MR-DOS/PWRLOAD-G1/README.md

# PWRLOAD-G1
DC constant current / constant power digitally controlled load, bachelor thesis in 2017
