MR-DOS/PWRLOAD-G1/exam/obhajoba_BP_final.pdf

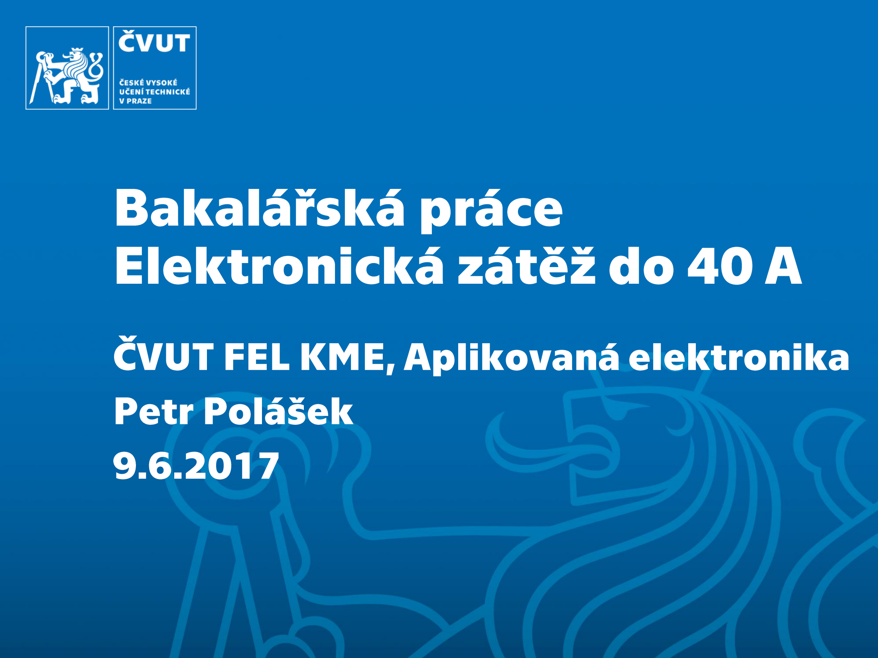
[picture p1: page 1]

1) Cíl práce
2) Základní myšlenky konstrukce
3) Princip funkce zátěže
4) Zapojení zpětnovazební smyčky
5) Digitální řízení
6) Mechanická konstrukce
7) Změřené parametry
8) Ukázka ovládání

Prostudovat problematiku zatěžování zdrojů Navrhnout a realizovat elektronickou zátěž schopnou zatěžovat zdroj s maximálním proudem do 40 A pro napětí do 100 V

Modularita
Softwarové řízení
Galvanické | oddělení výkonových | částí
obvodů od uživatelské části
Důraz na minimalizaci ceny zařízení

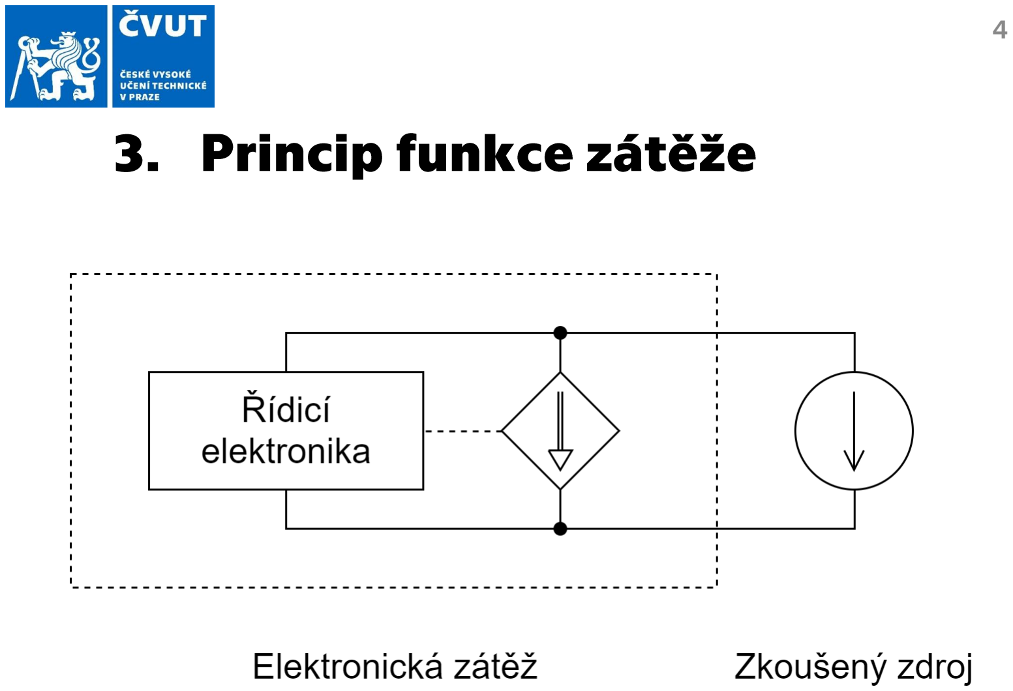
[picture p2: page 5]

Realizován přímo koncepcí zařízení jako proudové nory

Realizován simulací konstantního příkonu pomocí měření napětí na zatěžovaném zdroji a řízení proudu zátěží

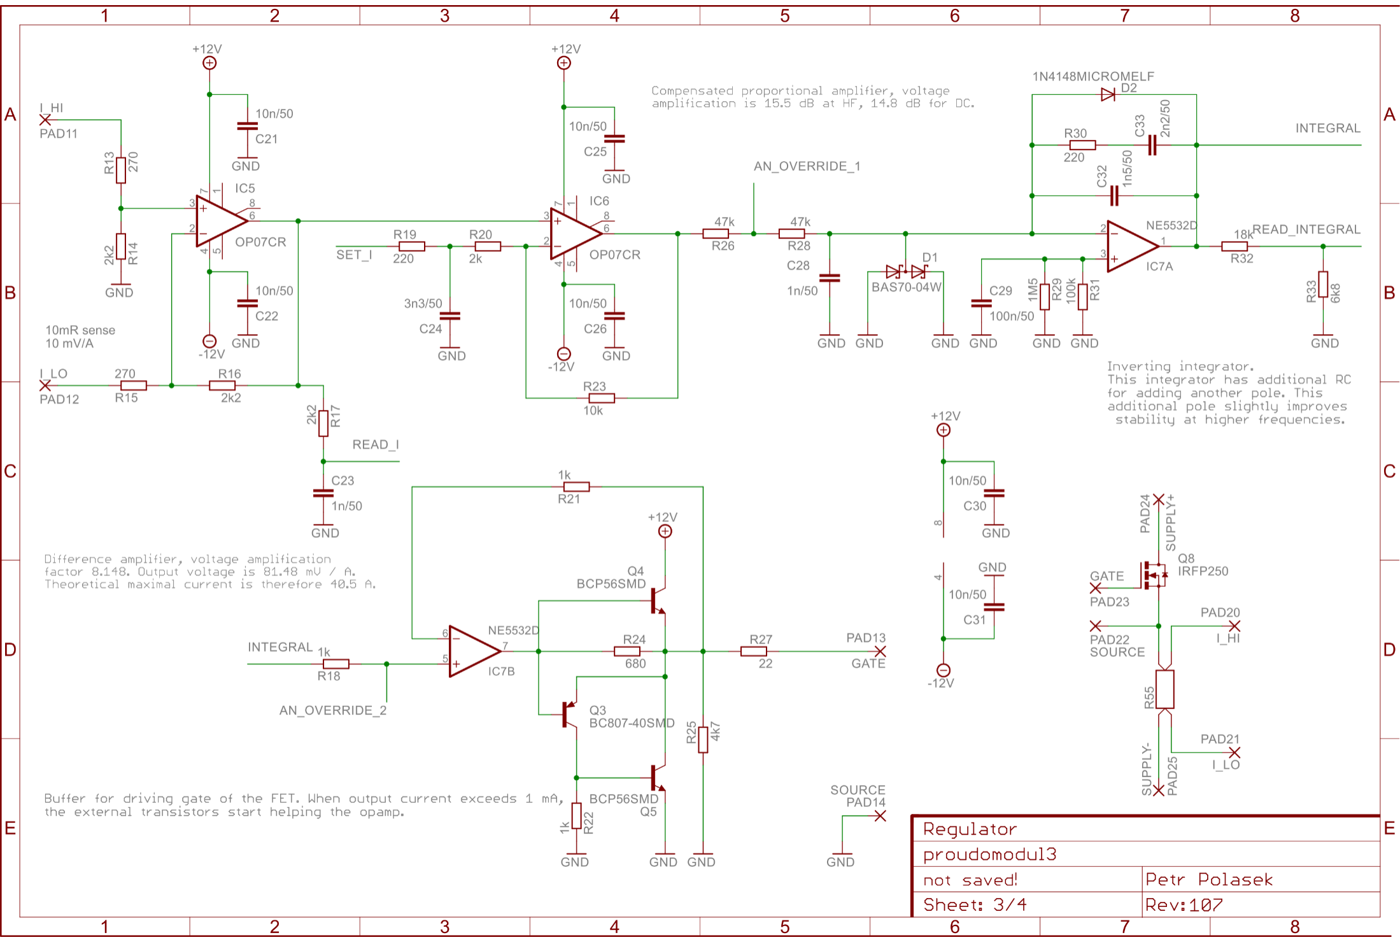
[picture p3: page 8]
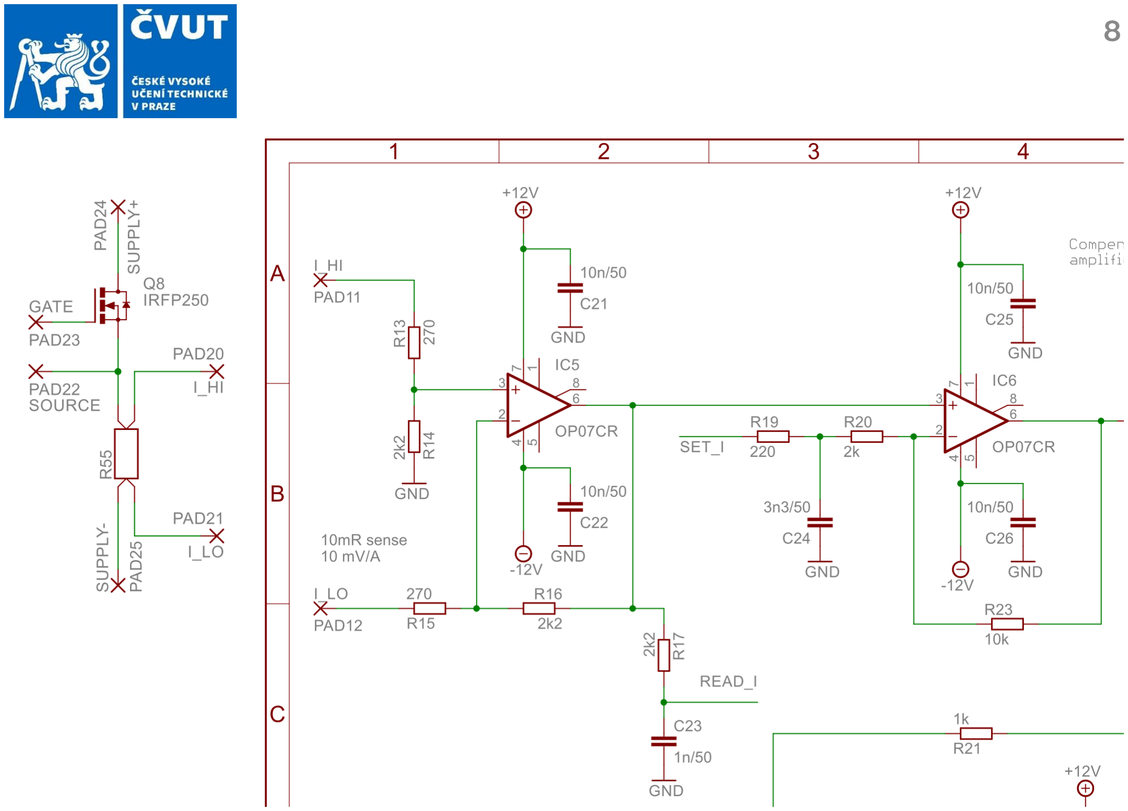
[picture p4: page 9]

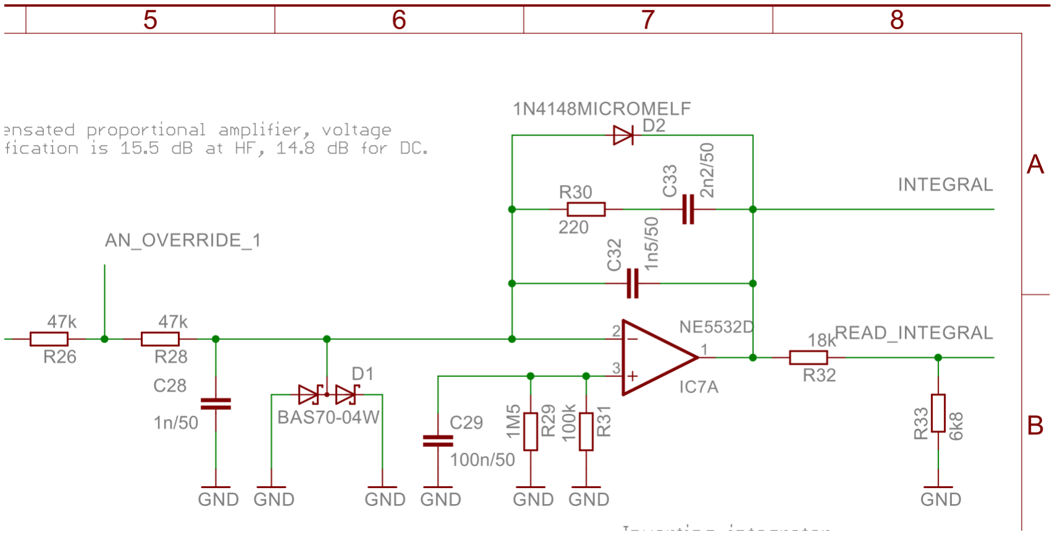
[picture p5: figure]

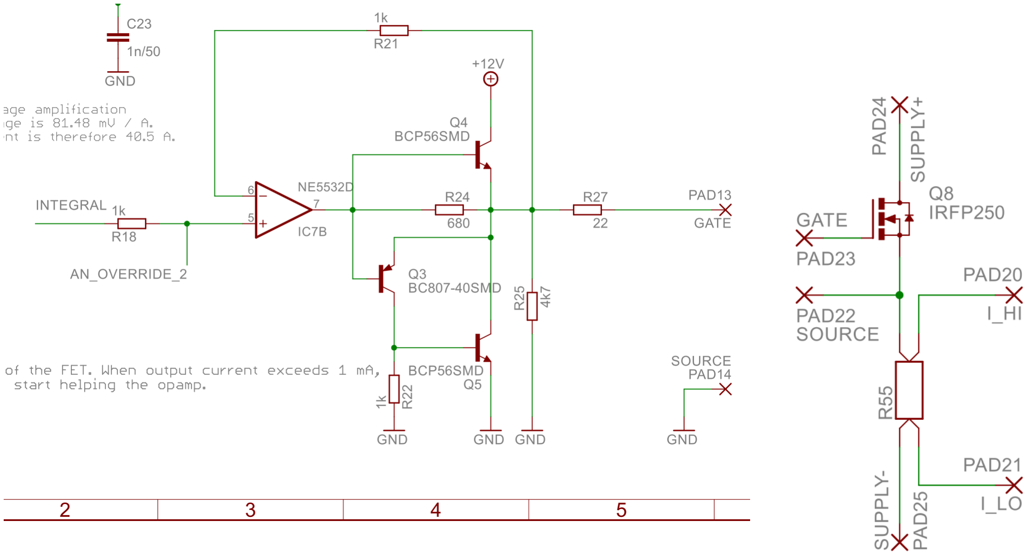
[picture p6: figure]
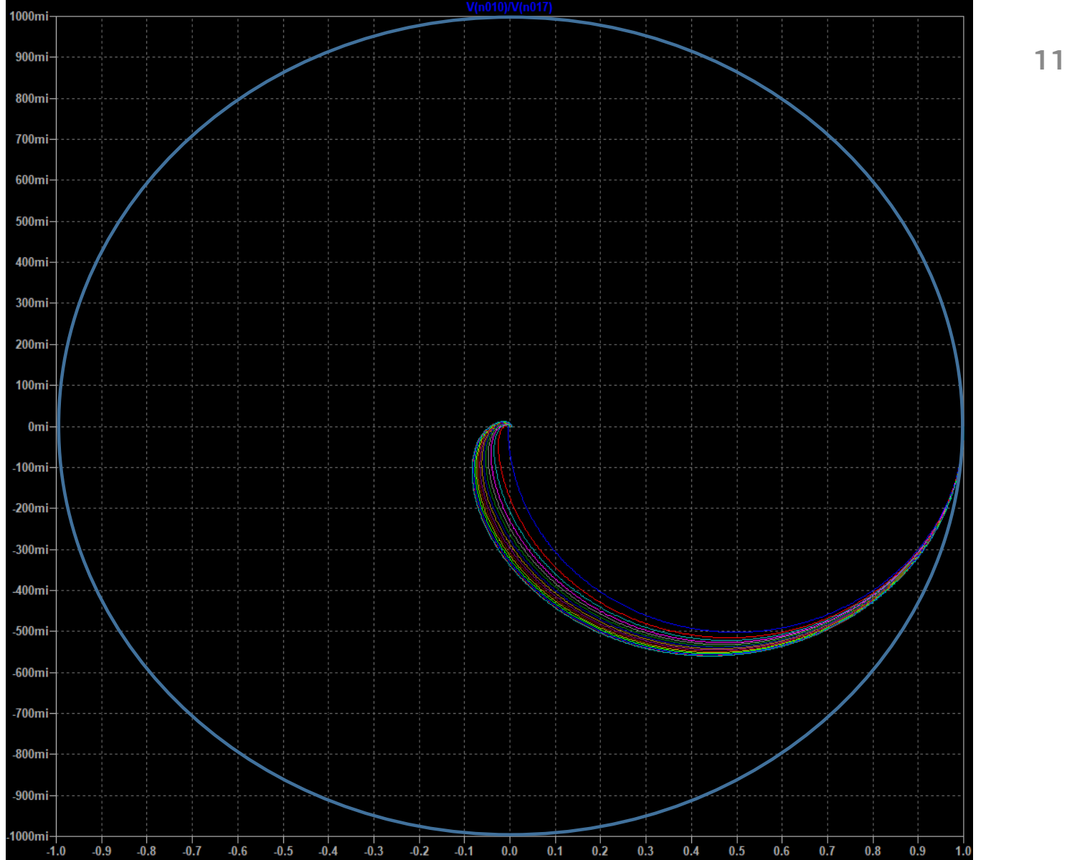
[picture p7: page 12]

Hlídání chybových stavů

Proudové přetížení

Výkonové přetížení
Přehřátí

Napětí zdroje
Řízení zátěže

Simulace konstantního příkonu

Digitální komunikace
Redukce počtu analogových obvodů

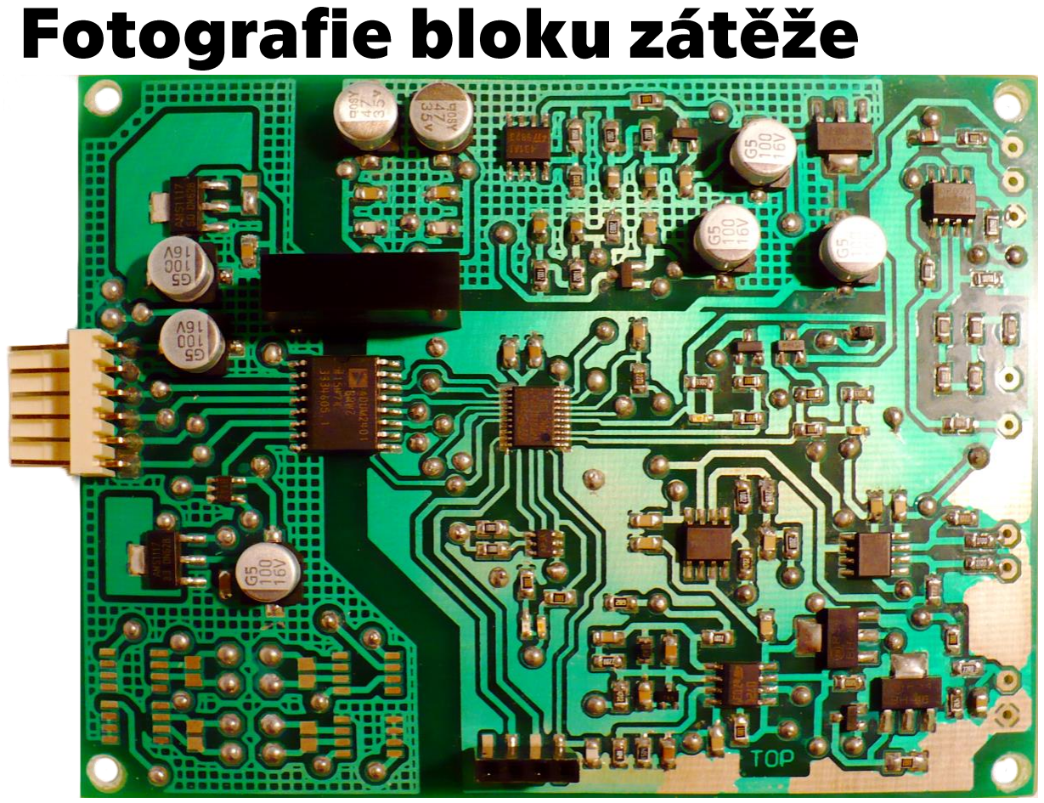
[picture p8: figure]
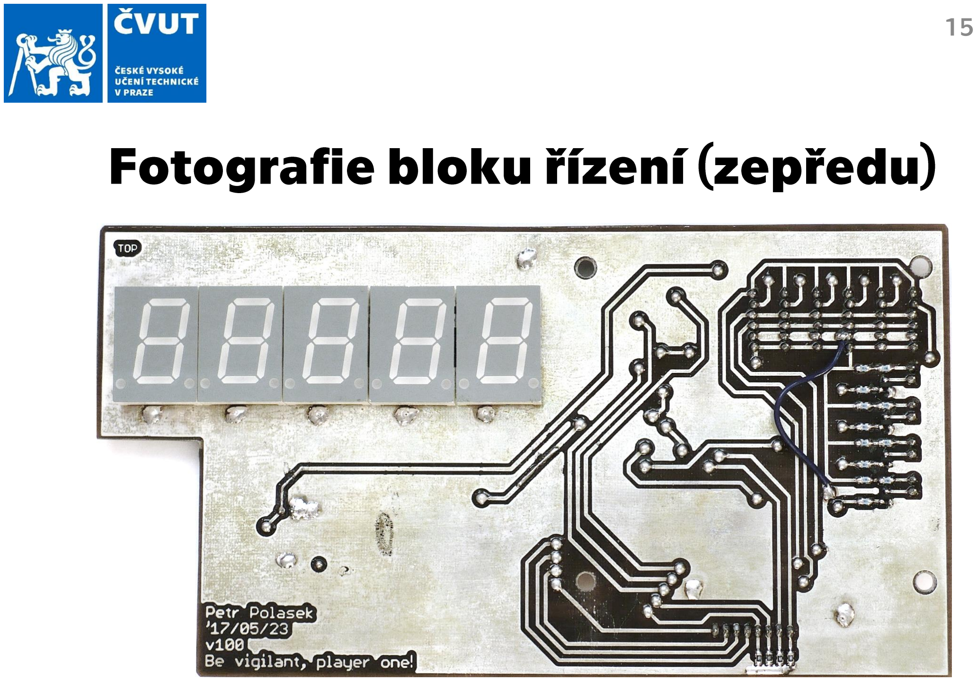
[picture p9: page 16]
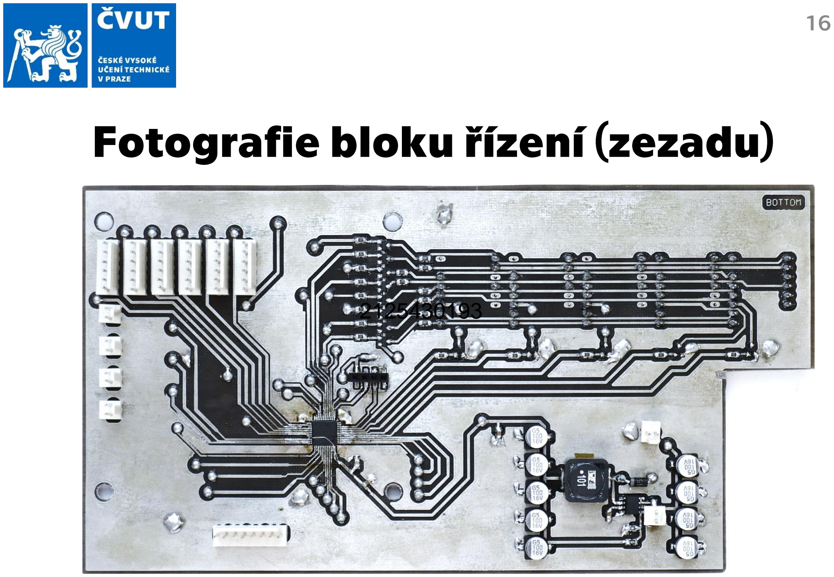
[picture p10: page 17]

2125430193

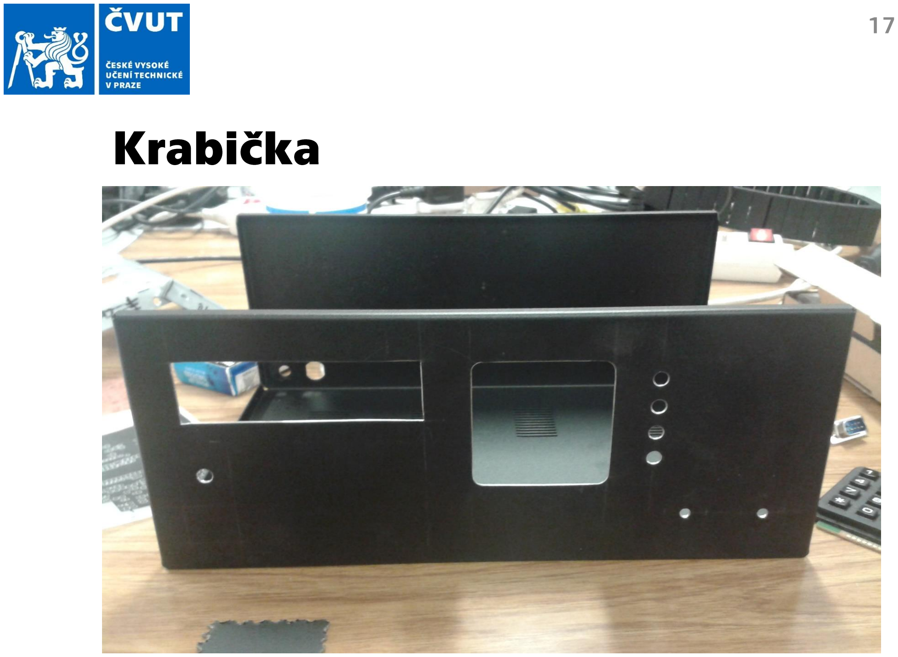
[picture p11: page 18]

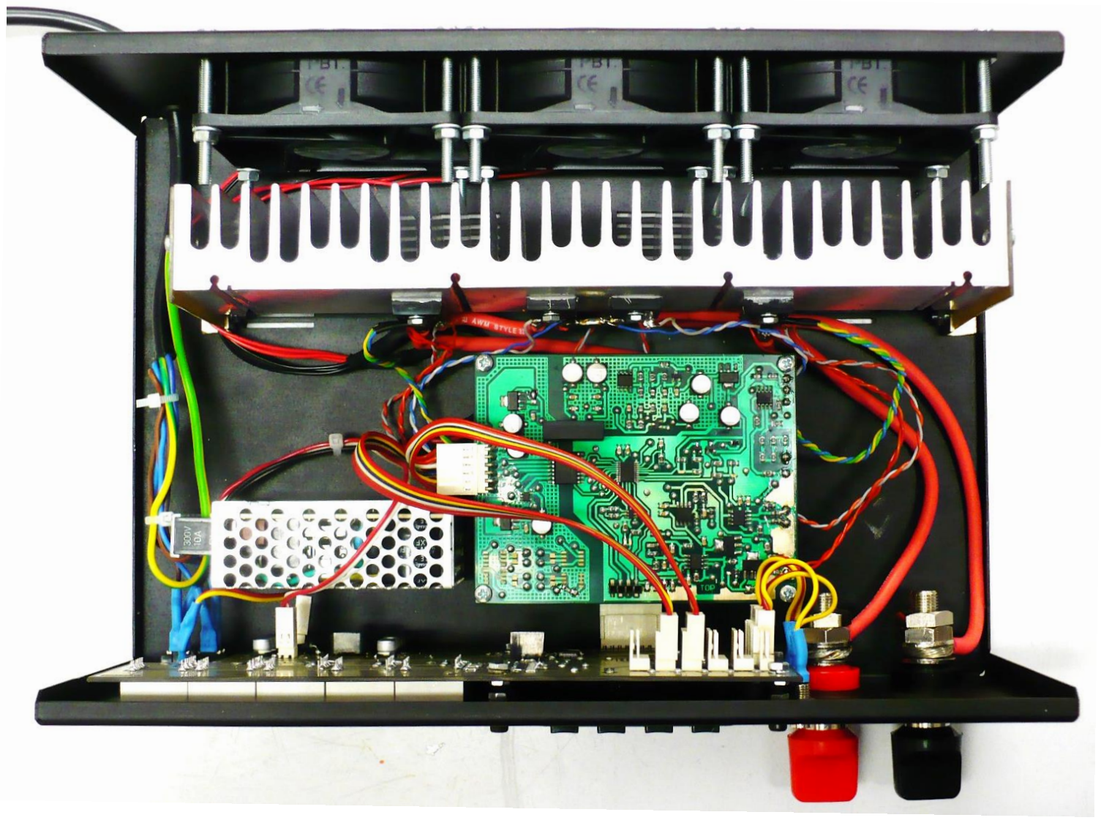
[picture p12: figure]

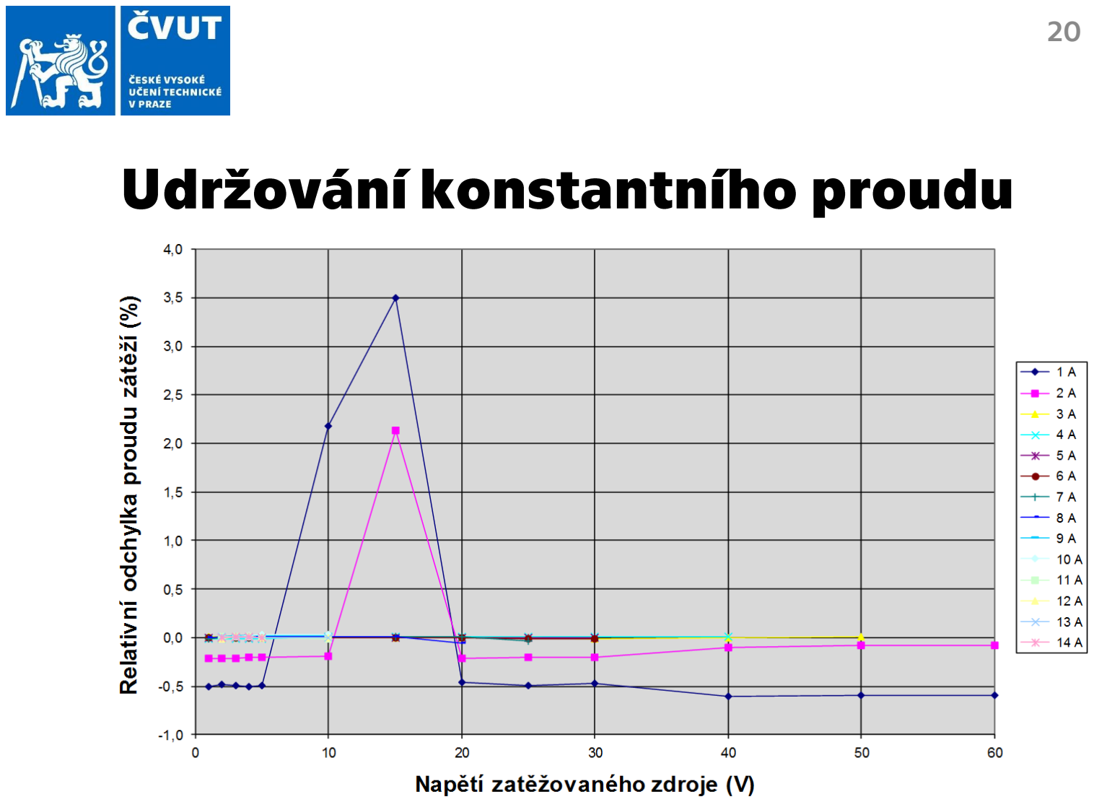
[picture p13: page 21]
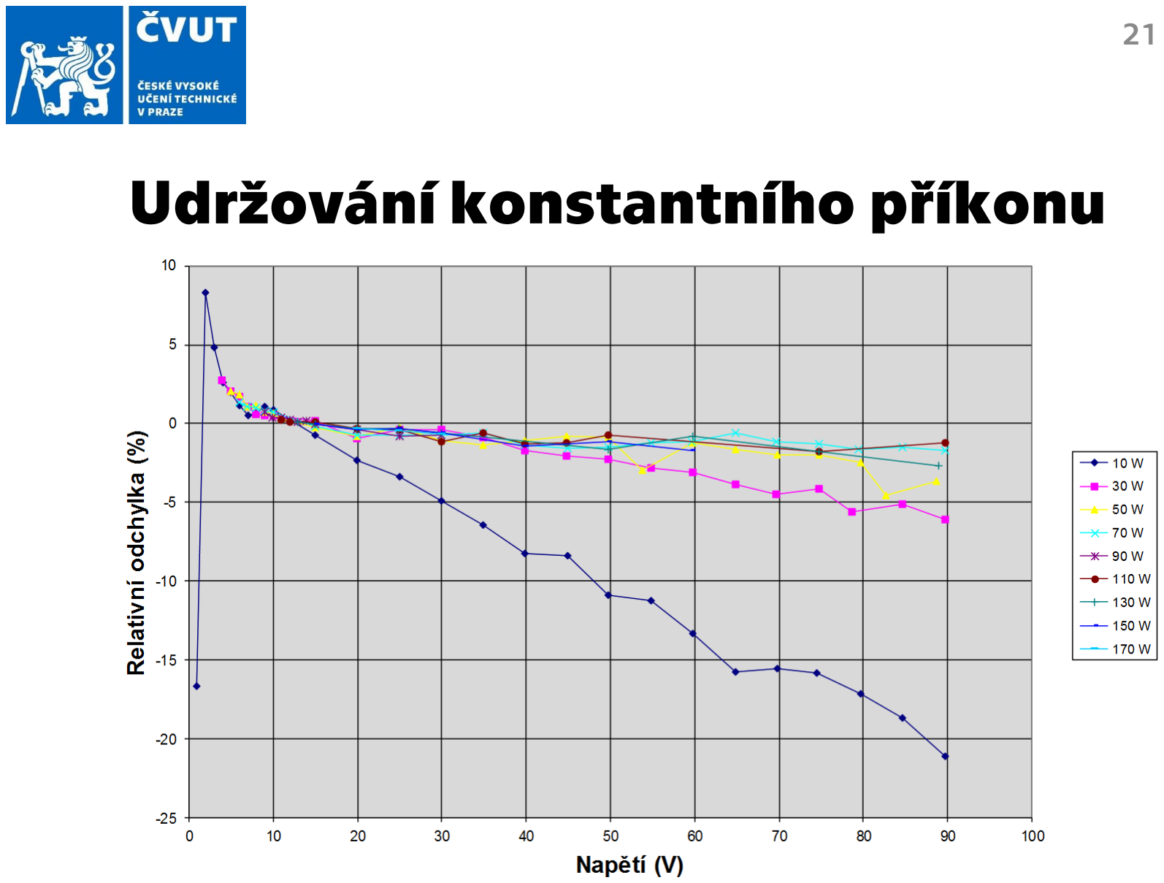
[picture p14: page 22]
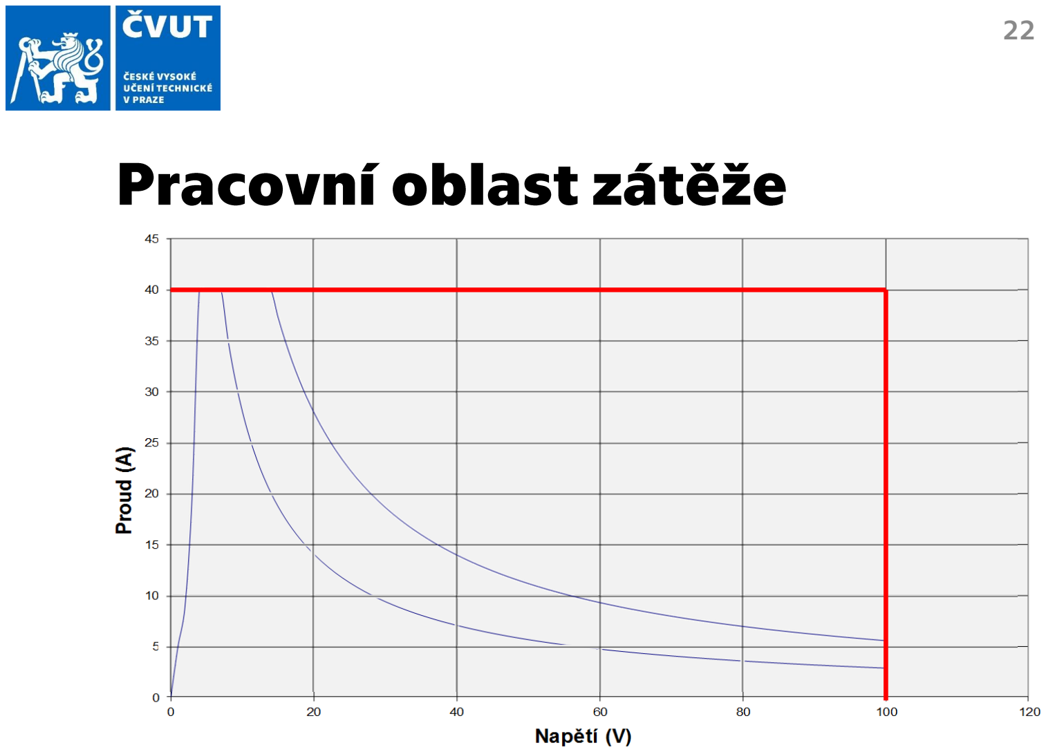
[picture p15: page 23]

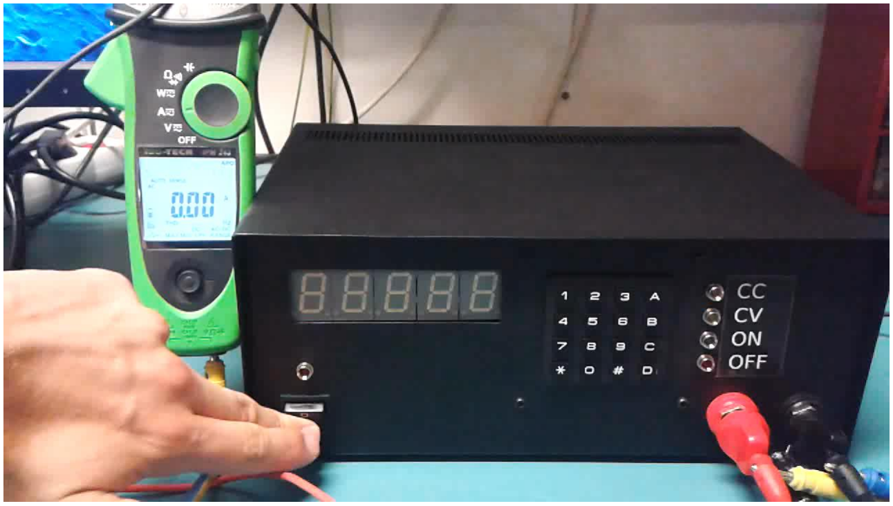
[picture p16: figure]

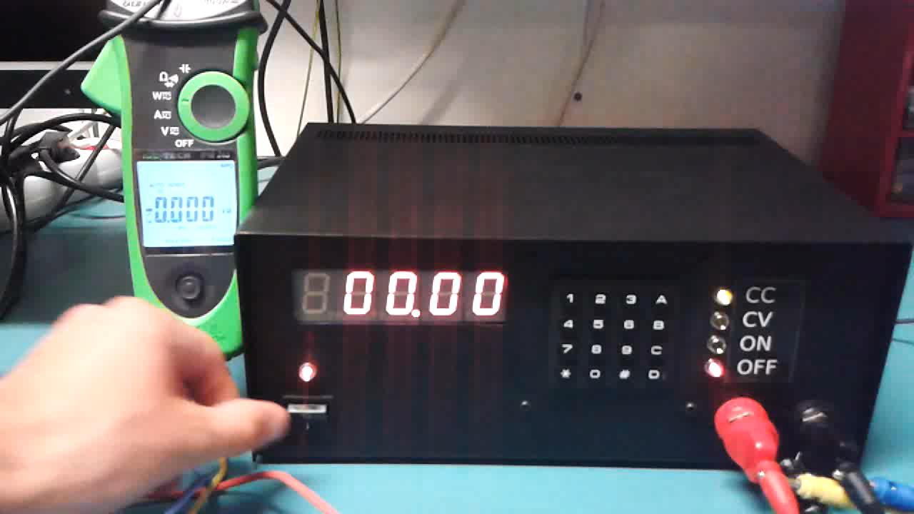
[picture p17: figure]

Prostudovat problematiku zatěžování zdrojů Navrhnout a realizovat elektronickou zátěž schopnou zatěžovat zdroj s maximálním proudem do 40 A pro napětí do 100 V

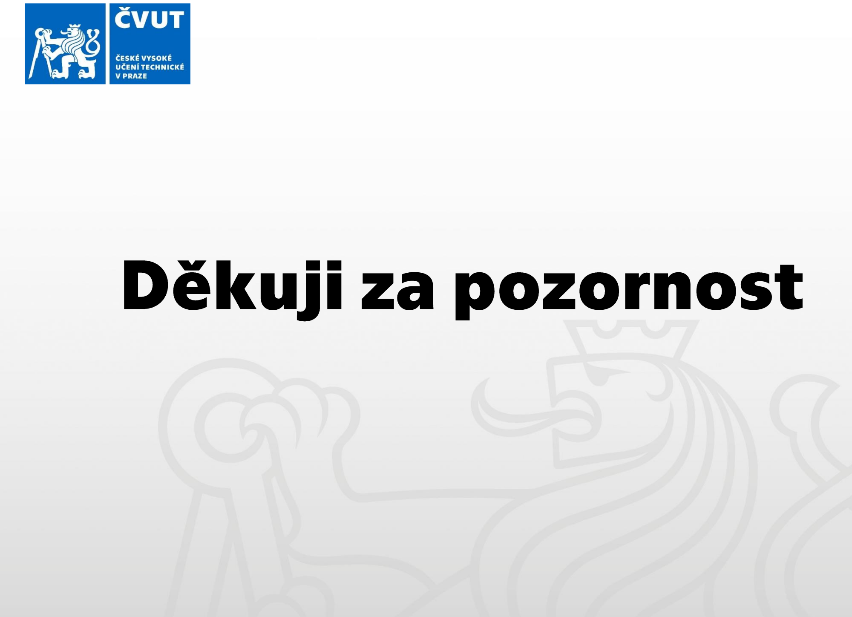
[picture p18: page 27]

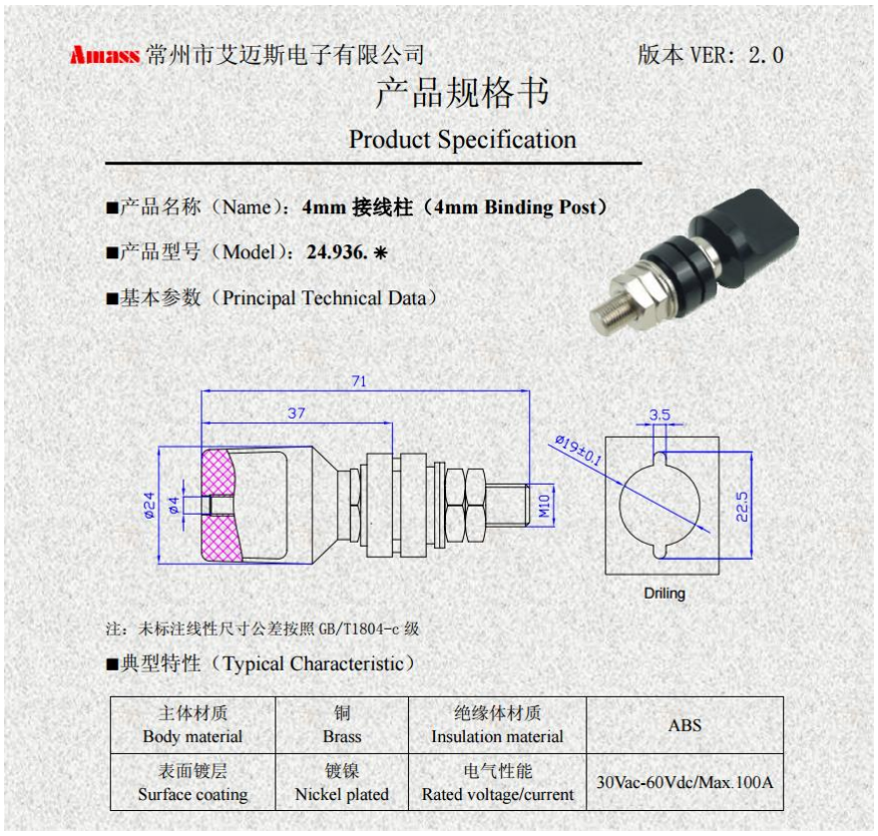
[picture p19: figure]
