MR-DOS/PWRLOAD-G1/thesis/namerena_data_prikon.xls

1 W |  |  |  | 10 W |  |  |  | 30 W
Napětí (V) | Proud (A) | Výkon (W) | Relativní chyba (%) | Napětí (V) | Proud (A) | Výkon (W) | Relativní chyba (%) | Napětí (V) | Proud (A) | Výkon (W) | Relativní chyba (%)
0.99 | 1.372 | 1.35828 | 35.828 | 0.938 | 8.890 | 8.339 | -16.612 | 3.942 | 7.820 | 30.826 | 2.755
1.995 | 0.5417 | 1.0806915 | 8.06915 | 1.960 | 5.527 | 10.833 | 8.329 | 4.950 | 6.186 | 30.621 | 2.069
2.994 | 0.338 | 1.011972 | 1.1972 | 2.973 | 3.526 | 10.483 | 4.828 | 5.960 | 5.120 | 30.515 | 1.717
3.99 | 0.2423 | 0.966777 | -3.3223 | 3.970 | 2.585 | 10.261 | 2.613 | 6.960 | 4.358 | 30.332 | 1.106
4.99 | 0.1883 | 0.939617 | -6.0383 | 4.980 | 2.048 | 10.200 | 1.995 | 7.960 | 3.791 | 30.176 | 0.588
5.99 | 0.1516 | 0.908084 | -9.1916 | 5.980 | 1.692 | 10.118 | 1.176 | 8.960 | 3.365 | 30.150 | 0.501
6.99 | 0.1258 | 0.879342 | -12.0658 | 6.980 | 1.440 | 10.049 | 0.491 | 9.960 | 3.028 | 30.159 | 0.530
7.99 | 0.1081 | 0.863719 | -13.6281 | 7.980 | 1.262 | 10.068 | 0.684 | 14.960 | 2.009 | 30.055 | 0.182
8.98 | 0.0928 | 0.833344 | -16.6656 | 8.980 | 1.126 | 10.108 | 1.079 | 19.960 | 1.489 | 29.720 | -0.932
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
