MR-DOS/PWRLOAD-G1/thesis/namerena_data_proud.xlsx

Měření závislosti proudu zátěží na napětí zdroje
Kodove slovo (-) | 119 | 243 | 368 | 491 | 615 | 738 | 862 | 987 | 1112 | 1236 | 1358 | 1481 | 1605 | 1730 |  | Hodnoty naměřené pomocí bočníku
Jmenovity proud (A) | 1 | 2 | 3 | 4 | 5 | 6 | 7 | 8 | 9 | 10 | 11 | 12 | 13 | 14
 |  |  |  |  |  |  |  |  |  |  |  |  |  |  |  | Proud (A)
Napeti (V) | Proud (A) |  |  |  |  |  |  |  |  |  |  |  |  |  | Napětí (V) | 6 | 7 | 8 | 9 | 10 | 11 | 12 | 13 | 14
1 | 1.0035 | 2.0056 | 3.0072 | 4.001 | 5.005 | 5.997 | 6.998 | 8.002 | 8.472 | 8.480 | 9.292 | 9.117 | 9.162 | 8.933 | 1 |  |  |  |  |  | 92.14 | 90.4 | 90.85 | 88.58
2 | 1.0033 | 2.0058 | 3.0072 | 4.001 | 5.005 | 5.997 | 6.997 | 8.001 | 9.002 | 10.000 | 11.004 | 11.998 | 13.001 | 14.009 | 2 |  |  |  |  |  | 109.11 | 118.97 | 128.91 | 138.91
3 | 1.0034 | 2.0056 | 3.0074 | 4.001 | 5.005 | 5.997 | 6.997 | 8.001 | 9.001 | 9.999 | 11.004 | 11.996 | 13.002 | 14.008 | 3 |  |  |  |  |  | 109.11 | 118.95 | 128.92 | 138.9
4 | 1.0035 | 2.0054 | 3.0072 | 4.001 | 5.005 | 5.997 | 6.997 | 8.001 | 9.001 | 9.998 | 11.004 | 11.996 | 13.002 | 14.008 | 4 |  |  |  |  |  | 109.11 | 118.95 | 128.92 | 138.9
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
