MR-DOS/PWRLOAD-G1/simulations/bap.asc

C1: cap; 3n3
C2: cap; 1n
C3: cap; 1n5
C4: cap; 2n2
M1: nmos; IRFP250N
Q1: npn3; BCW60A
Q2: npn3; BCW60A
Q3: pnp2; BC807-40
R1: res; 270
R2: res; 2k2
R3: res; 270
R4: res; 2k2
R5: res; 10k
R6: res; 2k
R7: res; 220
R8: res; 94k
R9: res; 220
R10: res; 1k
R11: res; 1k
R12: res; 10
R13: res; 1k
R14: res; 10m
U1: OP07
U2: OP07
U3: OP07
U4: OP07
V1: voltage; {DAC}; AC 0
V2: voltage; 10; AC 0
V3: voltage; 0; AC 1
V4: voltage; 11
V5: voltage; 11
Named nets: 0
.ac dec 10 1m 10k
;tran 0 30mm 0m 1u
.STEP param DAC 0.01 3.31 0.25
