MR-DOS/PWRLOAD-G1/HW_GUI/gui.brd

## EAGLE design HW_GUI/gui.brd (2022-01-06)

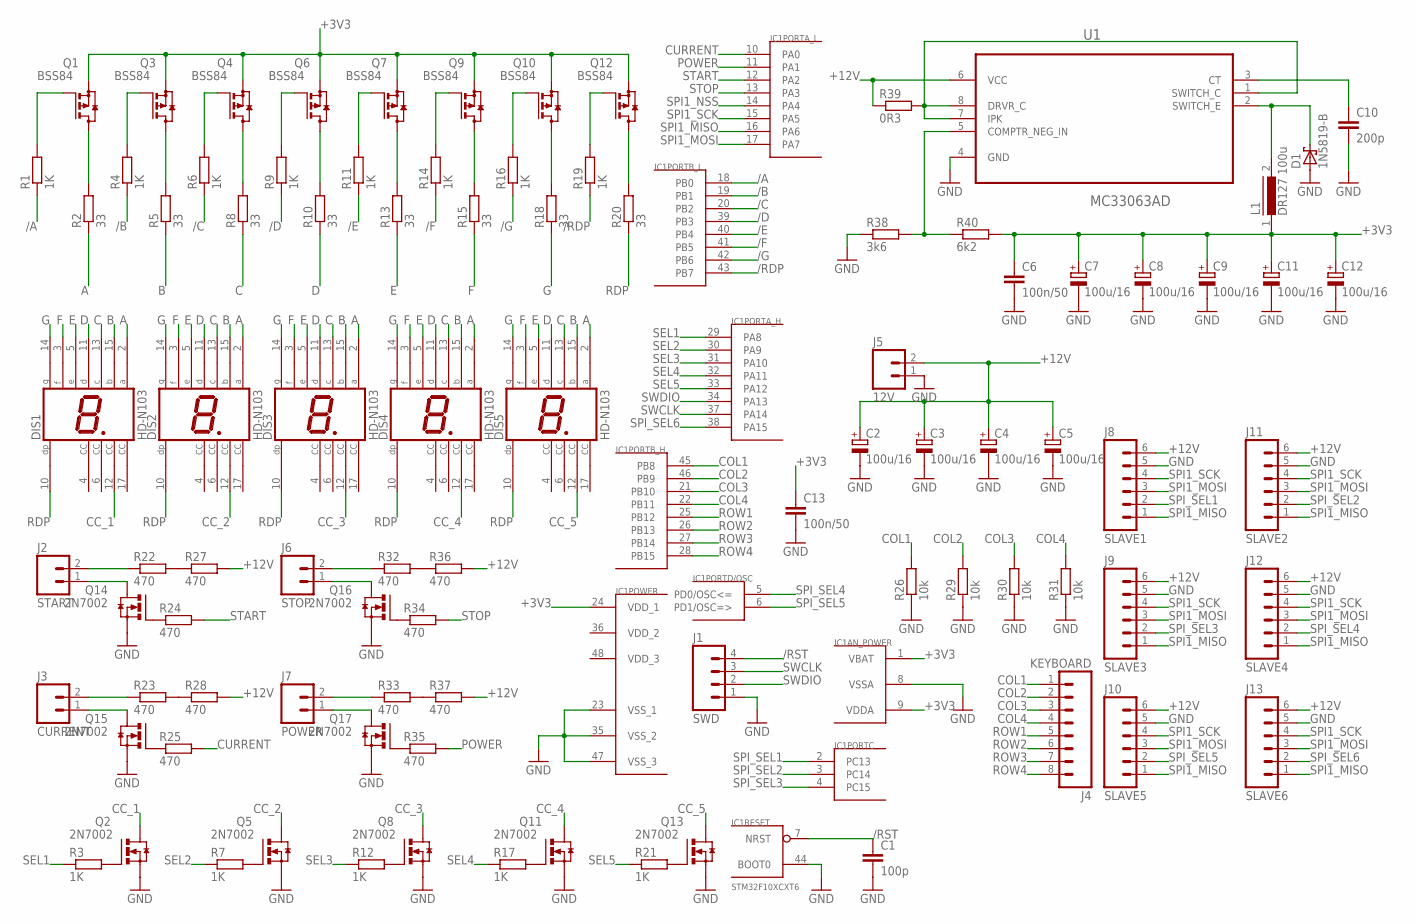
[picture p20: schematic gui.sch]

Parts:
C1: 100p; C0805
C2, C3, C4, C5, C7, C8, C9, C11, C12: 100u/16; 153CLV-0605
C6, C13: 100n/50; C0805
C10: 200p; C0805
D1: 1N5819-B; DO41-7.6
DIS1, DIS2, DIS3, DIS4, DIS5: HD-N103; HDSP-Q
IC1: STM32F10XCXT6; TQFP48
J1: SWD; 1X04_SMD_STRAIGHT_COMBO
J2: START; MOLEX-1X2_LOCK
J3: CURRENT; MOLEX-1X2_LOCK
J4: KEYBOARD; 1X08_LOCK_LONGPADS
J5: 12V; MOLEX-1X2_LOCK
J6: STOP; MOLEX-1X2_LOCK
J7: POWER; MOLEX-1X2_LOCK
J8: SLAVE1; MOLEX-1X6_LOCK
J9: SLAVE3; MOLEX-1X6_LOCK
J10: SLAVE5; MOLEX-1X6_LOCK
J11: SLAVE2; MOLEX-1X6_LOCK
J12: SLAVE4; MOLEX-1X6_LOCK
J13: SLAVE6; MOLEX-1X6_LOCK
L1: DR127 100u; DR127
Q1, Q3, Q4, Q6, Q7, Q9, Q10, Q12: BSS84; SOT23
Q2, Q5, Q8, Q11, Q13, Q14, Q15, Q16, Q17: 2N7002; SOT23-BEC
R1, R3, R4, R6, R7, R9, R11, R12, R14, R16, R17, R19, R21: 1K; R0805
R2, R5, R8, R10, R13, R15, R18, R20: 33; R0805
R22, R23, R24, R25, R27, R28, R32, R33, R34, R35, R36, R37: 470; R0805
R26, R29, R30, R31: 10k; R0805
R38: 3k6; R0805
R39: 0R3; R0805
R40: 6k2; R0805
U1: MC33063AD; SOIC127P600X175-8N

Connections:
+3V3: C6.1, C7.+, C8.+, C9.+, C11.+, C12.+, C13.1, IC1.1 (VBAT), IC1.9 (VDDA), IC1.24 (VDD_1), L1.1, Q1.2 (S), Q3.2 (S), Q4.2 (S), Q6.2 (S), Q7.2 (S), Q9.2 (S), Q10.2 (S), Q12.2 (S), R40.2
+12V: C2.+, C3.+, C4.+, C5.+, J5.2, J8.6, J9.6, J10.6, J11.6, J12.6, J13.6, R27.2, R28.2, R36.2, R37.2, R39.1, U1.6 (VCC)
/A: IC1.18 (PB0), R1.1
/B: IC1.19 (PB1), R4.1
/C: IC1.20 (PB2), R6.1
/D: IC1.39 (PB3), R9.1
/E: IC1.40 (PB4), R11.1
/F: IC1.41 (PB5), R14.1
/G: IC1.42 (PB6), R16.1
/RDP: IC1.43 (PB7), R19.1
/RST: C1.1, IC1.7 (NRST), J1.4
A: DIS1.2 (A), DIS2.2 (A), DIS3.2 (A), DIS4.2 (A), DIS5.2 (A), R2.1
B: DIS1.15 (B), DIS2.15 (B), DIS3.15 (B), DIS4.15 (B), DIS5.15 (B), R5.1
C: DIS1.13 (C), DIS2.13 (C), DIS3.13 (C), DIS4.13 (C), DIS5.13 (C), R8.1
CC_1: DIS1.12 (CC), Q2.C (D)
CC_2: DIS2.12 (CC), Q5.C (D)
CC_3: DIS3.12 (CC), Q8.C (D)
CC_4: DIS4.12 (CC), Q11.C (D)
CC_5: DIS5.12 (CC), Q13.C (D)
COL1: IC1.45 (PB8), J4.1, R26.2
COL2: IC1.46 (PB9), J4.2, R29.2
COL3: IC1.21 (PB10), J4.3, R30.2
COL4: IC1.22 (PB11), J4.4, R31.2
CURRENT: IC1.10 (PA0), R25.2
D: DIS1.11 (D), DIS2.11 (D), DIS3.11 (D), DIS4.11 (D), DIS5.11 (D), R10.1
E: DIS1.5 (E), DIS2.5 (E), DIS3.5 (E), DIS4.5 (E), DIS5.5 (E), R13.1
F: DIS1.3 (F), DIS2.3 (F), DIS3.3 (F), DIS4.3 (F), DIS5.3 (F), R15.1
G: DIS1.14 (G), DIS2.14 (G), DIS3.14 (G), DIS4.14 (G), DIS5.14 (G), R18.1
GND: C1.2, C2.-, C3.-, C4.-, C5.-, C6.2, C7.-, C8.-, C9.-, C10.2, C11.-, C12.-, C13.2, D1.A, IC1.8 (VSSA), IC1.23 (VSS_1), IC1.35 (VSS_2), IC1.44 (BOOT0), IC1.47 (VSS_3), J1.1, J5.1, J8.5, J9.5, J10.5, J11.5, J12.5, J13.5, Q2.E (S), Q5.E (S), Q8.E (S), Q11.E (S), Q13.E (S), Q14.E (S), Q15.E (S), Q16.E (S), Q17.E (S), R26.1, R29.1, R30.1, R31.1, R38.1, U1.4 (GND)
N3: Q8.B (G), R12.2
unnamed: Q1.3 (D), R2.2
unnamed: Q3.3 (D), R5.2
unnamed: Q4.3 (D), R8.2
unnamed: Q6.3 (D), R10.2
unnamed: Q7.3 (D), R13.2
unnamed: Q9.3 (D), R15.2
unnamed: Q10.3 (D), R18.2
unnamed: Q12.3 (D), R20.2
unnamed: Q11.B (G), R17.2
unnamed: Q2.B (G), R3.2
unnamed: Q5.B (G), R7.2
unnamed: Q13.B (G), R21.2
unnamed: Q12.1 (G), R19.2
unnamed: Q10.1 (G), R16.2
unnamed: Q9.1 (G), R14.2
unnamed: Q7.1 (G), R11.2
unnamed: Q6.1 (G), R9.2
unnamed: Q4.1 (G), R6.2
unnamed: Q3.1 (G), R4.2
unnamed: Q1.1 (G), R1.2
unnamed: J3.1, Q15.C (D)
unnamed: J7.1, Q17.C (D)
unnamed: J3.2, R23.1
unnamed: R23.2, R28.1
unnamed: J7.2, R33.1
unnamed: R33.2, R37.1
unnamed: J2.1, Q14.C (D)
unnamed: J2.2, R22.1
unnamed: R22.2, R27.1
unnamed: J6.1, Q16.C (D)
unnamed: J6.2, R32.1
unnamed: R32.2, R36.1
unnamed: R38.2, R40.1, U1.5 (COMPTR_NEG_IN)
unnamed: C10.1, U1.3 (CT)
unnamed: Q14.B (G), R24.1
unnamed: R39.2, U1.1 (SWITCH_C), U1.7 (IPK), U1.8 (DRVR_C)
unnamed: D1.C, L1.2, U1.2 (SWITCH_E)
unnamed: Q15.B (G), R25.1
unnamed: Q16.B (G), R34.1
unnamed: Q17.B (G), R35.1
POWER: IC1.11 (PA1), R35.2
RDP: DIS1.10 (DP), DIS2.10 (DP), DIS3.10 (DP), DIS4.10 (DP), DIS5.10 (DP), R20.1
ROW1: IC1.25 (PB12), J4.5
ROW2: IC1.26 (PB13), J4.6
ROW3: IC1.27 (PB14), J4.7
ROW4: IC1.28 (PB15), J4.8
SEL1: IC1.29 (PA8), R3.1
SEL2: IC1.30 (PA9), R7.1
SEL3: IC1.31 (PA10), R12.1
SEL4: IC1.32 (PA11), R17.1
SEL5: IC1.33 (PA12), R21.1
SPI1_MISO: IC1.16 (PA6), J8.1, J9.1, J10.1, J11.1, J12.1, J13.1
SPI1_MOSI: IC1.17 (PA7), J8.3, J9.3, J10.3, J11.3, J12.3, J13.3
SPI1_NSS: IC1.14 (PA4)
SPI1_SCK: IC1.15 (PA5), J8.4, J9.4, J10.4, J11.4, J12.4, J13.4
SPI_SEL1: IC1.2 (PC13), J8.2
SPI_SEL2: IC1.3 (PC14), J11.2
SPI_SEL3: IC1.4 (PC15), J9.2
SPI_SEL4: IC1.5 (PD0/OSC<=), J12.2
SPI_SEL5: IC1.6 (PD1/OSC=>), J10.2
SPI_SEL6: IC1.38 (PA15), J13.2
START: IC1.12 (PA2), R24.2
STOP: IC1.13 (PA3), R34.2
SWCLK: IC1.37 (PA14), J1.3
SWDIO: IC1.34 (PA13), J1.2
VDD_2: IC1.36 (VDD_2)
VDD_3: IC1.48 (VDD_3)

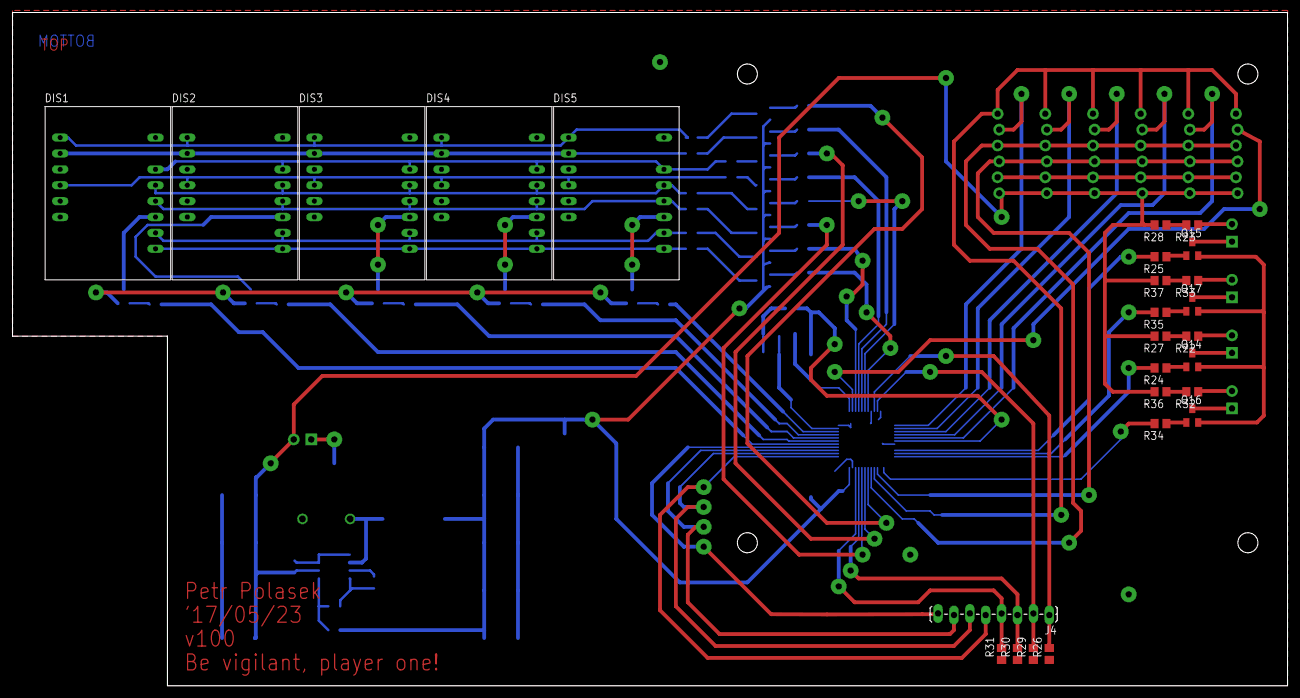
[picture p21: board gui.brd from above]

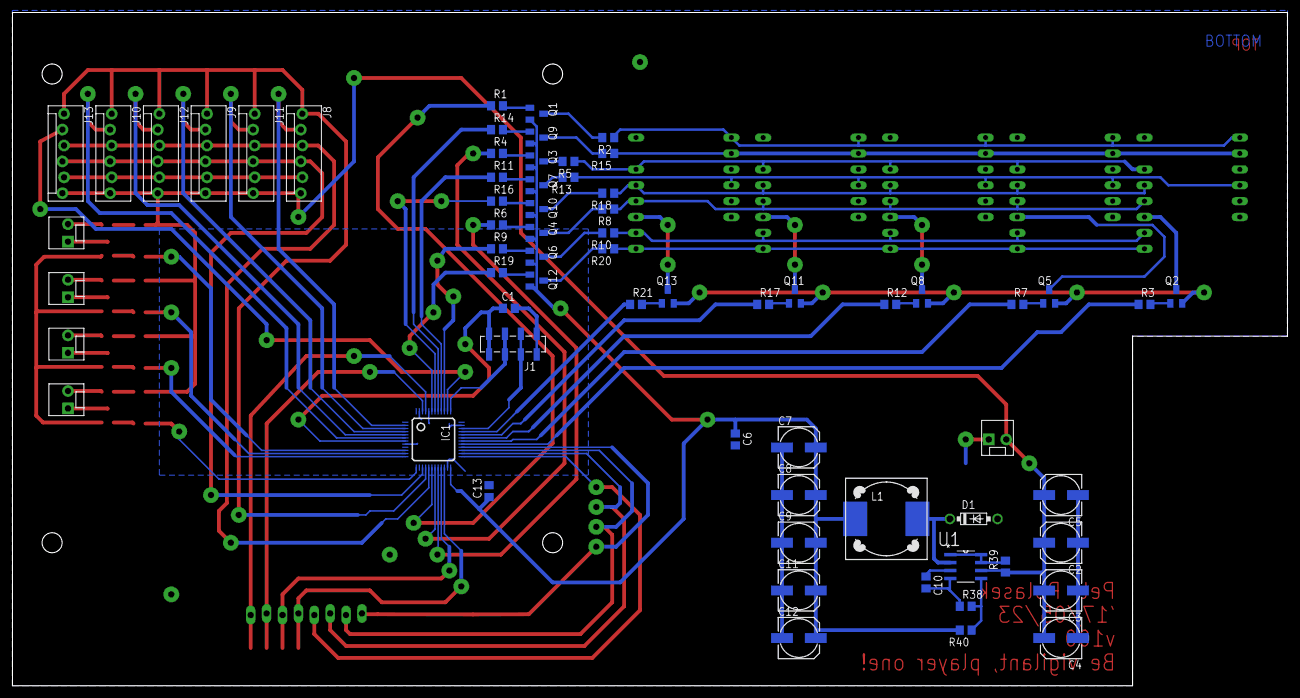
[picture p22: board gui.brd from below]

Board: 2 copper layers, 203.8 x 107.6 mm, 92 parts (66 on the bottom side), 94 nets.
