MR-DOS/PWRLOAD-G1/HW_load/proudomodul3.brd

## EAGLE design HW_load/proudomodul3.brd (2022-01-06)

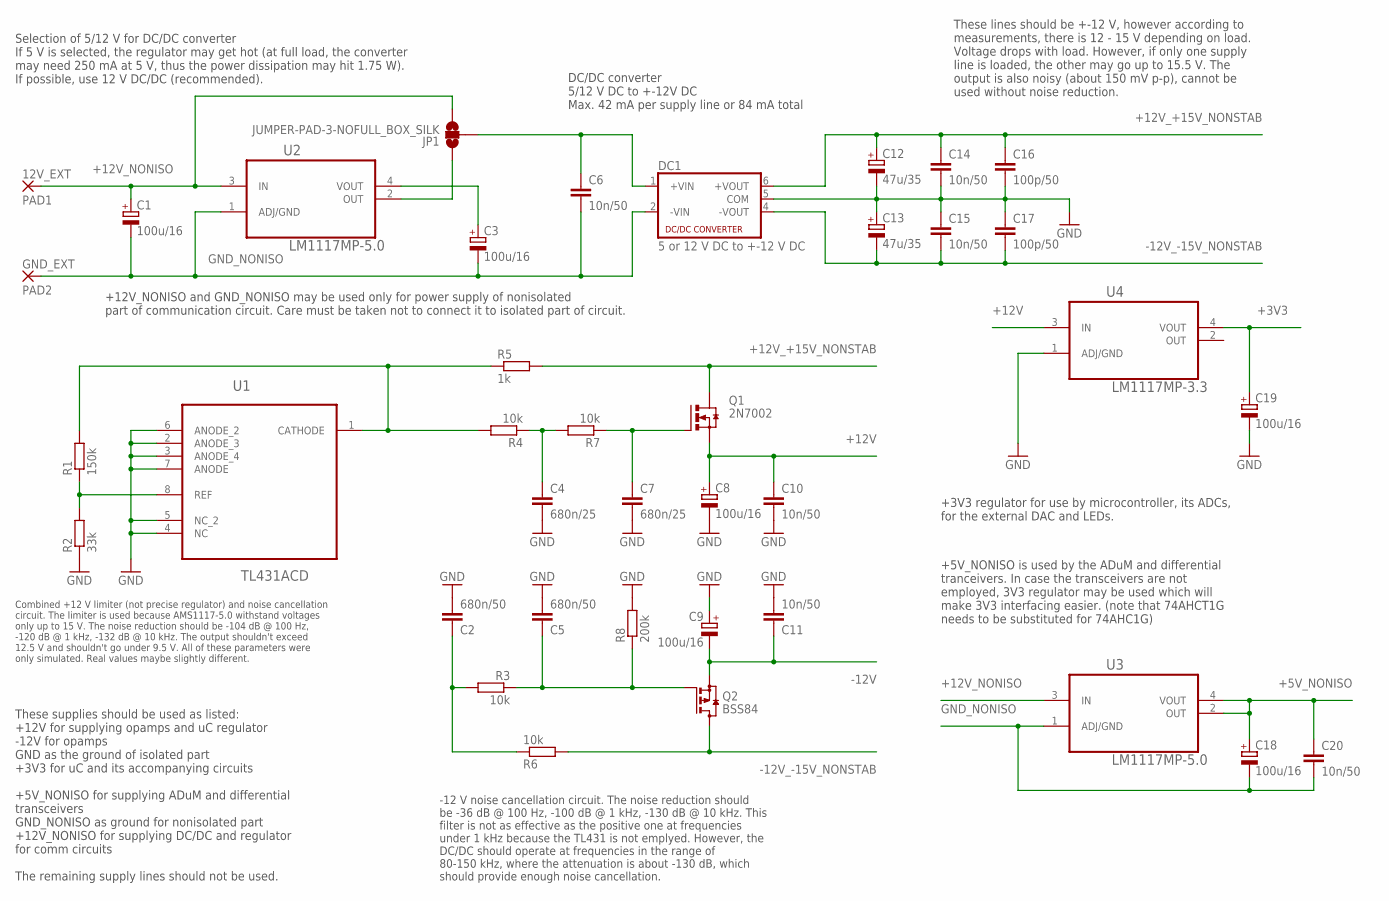
[picture p23: schematic proudomodul3.sch, sheet 1, Power supply]

Parts:
C1, C3, C8, C9, C18, C19: 100u/16; 153CLV-0605
C2, C5: 680n/50; C0805
C4, C7: 680n/25; C0805
C6, C10, C11, C14, C15, C20: 10n/50; C0805
C12, C13: 47u/35; 153CLV-0605
C16, C17: 100p/50; C0805
DC1: 5 or 12 V DC to +-12 V DC; NMA
JP1: JUMPER-PAD-3-NOFULL_BOX_SILK; PAD-JUMPER-3-NO_YES_SILK_FULL_BOX
PAD1: 12V_EXT; 2,15/1,0
PAD2: GND_EXT; 2,15/1,0
Q1: 2N7002; SOT23-BEC
Q2: BSS84; SOT23
R1: 150k; R0805
R2: 33k; R0805
R3, R4, R6, R7: 10k; R0805
R5: 1k; R0805
R8: 200k; R0805
U1: TL431ACD; SOIC127P600X175-8N
U2, U3: LM1117MP-5.0; SOT230P696X180-4N
U4: LM1117MP-3.3; SOT230P696X180-4N

Connections:
+3V3: C19.+, U4.4 (VOUT); also elsewhere on the board
+5V_NONISO: C18.+, C20.1, U3.2 (OUT), U3.4 (VOUT); also elsewhere on the board
+12V: C8.+, C10.1, Q1.E (S), U4.3 (IN); also elsewhere on the board
+12V_+15V_NONSTAB: C12.+, C14.1, C16.1, DC1.6 (+VOUT), Q1.C (D), R5.2
+12V_NONISO: C1.+, JP1.3, PAD1.1, U2.3 (IN), U3.3 (IN); also elsewhere on the board
-12V: C9.-, C11.1, Q2.2 (S); also elsewhere on the board
-12V_-15V_NONSTAB: C13.-, C15.2, C17.2, DC1.4 (-VOUT), Q2.3 (D), R6.2
GND: C2.2, C4.2, C5.2, C7.2, C8.-, C9.+, C10.2, C11.2, C12.-, C13.+, C14.2, C15.1, C16.2, C17.1, C19.-, DC1.5 (COM), R2.1, R8.2, U1.2 (ANODE_3), U1.3 (ANODE_4), U1.4 (NC), U1.5 (NC_2), U1.6 (ANODE_2), U1.7 (ANODE), U4.1 (ADJ/GND); also elsewhere on the board
GND_NONISO: C1.-, C3.-, C6.2, C18.-, C20.2, DC1.2 (-VIN), PAD2.1, U2.1 (ADJ/GND), U3.1 (ADJ/GND); also elsewhere on the board
unnamed: C4.1, R4.1, R7.2
unnamed: C6.1, DC1.1 (+VIN), JP1.2
unnamed: R1.1, R2.2, U1.8 (REF)
unnamed: R1.2, R4.2, R5.1, U1.1 (CATHODE)
unnamed: C7.1, Q1.B (G), R7.1
unnamed: C2.1, R3.2, R6.1
unnamed: C5.1, Q2.1 (G), R3.1, R8.1
unnamed: JP1.1, U2.2 (OUT)
unnamed: C3.+, U2.4 (VOUT)

Notes on the sheet:
DC/DC converter 5/12 V DC to +-12V DC Max. 42 mA per supply line or 84 mA total
Selection of 5/12 V for DC/DC converter If 5 V is selected, the regulator may get hot (at full load, the converter may need 250 mA at 5 V, thus the power dissipation may hit 1.75 W). If possible, use 12 V DC/DC (recommended).
These lines should be +-12 V, however according to measurements, there is 12 - 15 V depending on load. Voltage drops with load. However, if only one supply line is loaded, the other may go up to 15.5 V. The output is also noisy (about 150 mV p-p), cannot be used without noise reduction.
Combined +12 V limiter (not precise regulator) and noise cancellation circuit. The limiter is used because AMS1117-5.0 withstand voltages only up to 15 V. The noise reduction should be -104 dB @ 100 Hz, -120 dB @ 1 kHz, -132 dB @ 10 kHz. The output shouldn't exceed 12.5 V and shouldn't go under 9.5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
-12 V noise cancellation circuit. The noise reduction should be -36 dB @ 100 Hz, -100 dB @ 1 kHz, -130 dB @ 10 kHz. This filter is not as effective as the positive one at frequencies under 1 kHz because the TL431 is not emplyed. However, the DC/DC should operate at frequencies in the range of 80-15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
+12V_NONISO and GND_NONISO may be used only for power supply of nonisolated part of communication circuit. Care must be taken not to connect it to isolated part of circuit.
+3V3 regulator for use by microcontroller, its ADCs, for the external DAC and LEDs.
These supplies should be used as listed: +12V for supplying opamps and uC regulator -12V for opamps GND as the ground of isolated part +3V3 for uC and its accompanying circuits +5V_NONISO for supplying ADuM and differential transceivers GND_NONISO as ground for nonisolated part +12V_NONISO for supp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
+5V_NONISO is used by the ADuM and differential tranceivers. In case the transceivers are not employed, 3V3 regulator may be used which will make 3V3 interfacing easier. (note that 74AHCT1G needs to be substituted for 74AHC1G)

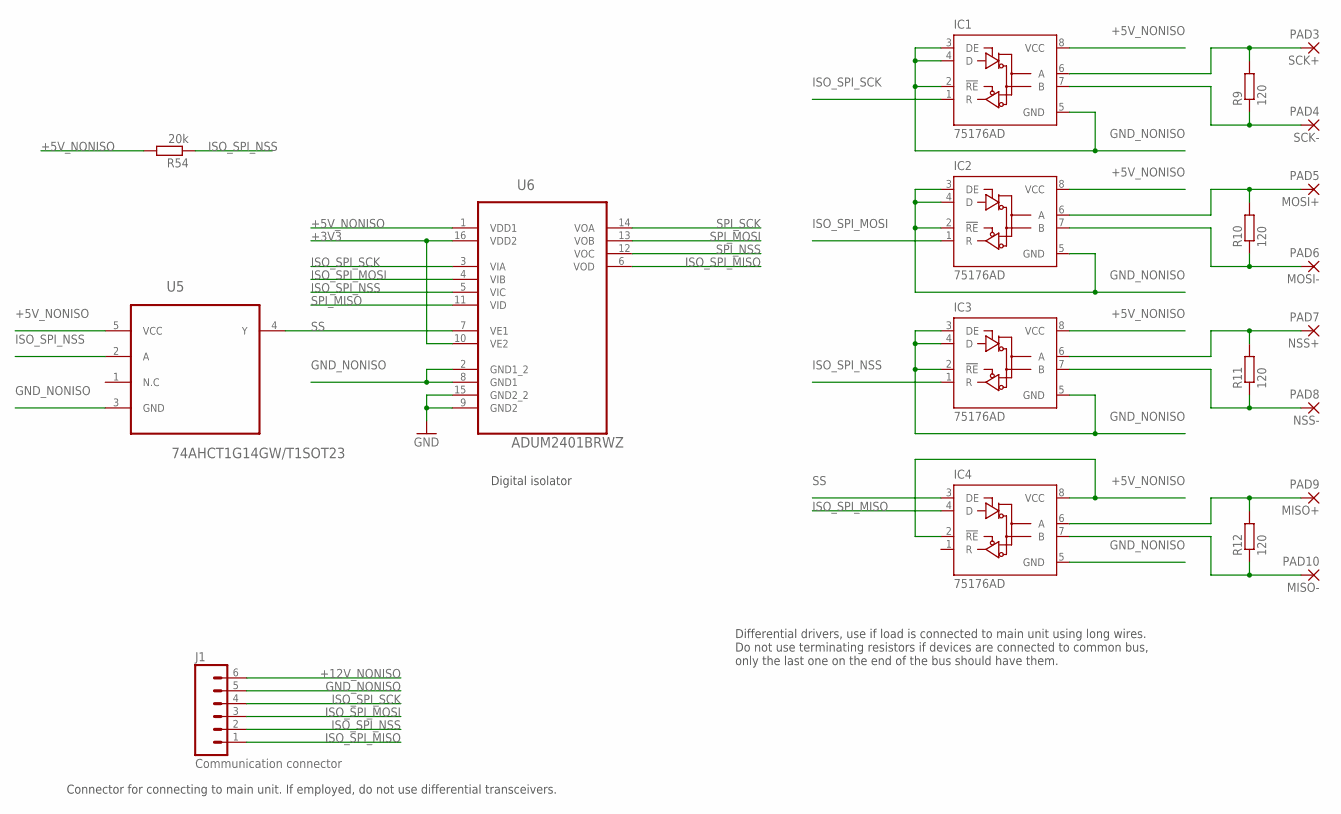
[picture p24: schematic proudomodul3.sch, sheet 2, Isolated comm circuits]

Parts:
IC1, IC2, IC3, IC4: 75176AD; D_R-PDSO-G8
J1: Communication connector; MOLEX-1X6-RA_LOCK
PAD3: SCK+; 2,15/1,0
PAD4: SCK-; 2,15/1,0
PAD5: MOSI+; 2,15/1,0
PAD6: MOSI-; 2,15/1,0
PAD7: NSS+; 2,15/1,0
PAD8: NSS-; 2,15/1,0
PAD9: MISO+; 2,15/1,0
PAD10: MISO-; 2,15/1,0
R9, R10, R11, R12: 120; R0805
R54: 20k; R0805
U5: 74AHCT1G14GW/T1SOT23; SOT23-5L
U6: ADUM2401BRWZ; SOIC127P1032X265-16N

Connections:
+3V3: U6.10 (VE2), U6.16 (VDD2); also elsewhere on the board
+5V_NONISO: IC1.8 (VCC), IC2.8 (VCC), IC3.8 (VCC), IC4.2 (!RE), IC4.8 (VCC), R54.2, U5.5 (VCC), U6.1 (VDD1); also elsewhere on the board
+12V_NONISO: J1.6; also elsewhere on the board
GND: U6.9 (GND2), U6.15 (GND2_2); also elsewhere on the board
GND_NONISO: IC1.2 (!RE), IC1.3 (DE), IC1.4 (D), IC1.5 (GND), IC2.2 (!RE), IC2.3 (DE), IC2.4 (D), IC2.5 (GND), IC3.2 (!RE), IC3.3 (DE), IC3.4 (D), IC3.5 (GND), IC4.5 (GND), J1.5, U5.3 (GND), U6.2 (GND1_2), U6.8 (GND1); also elsewhere on the board
ISO_SPI_MISO: IC4.4 (D), J1.1, U6.6 (VOD)
ISO_SPI_MOSI: IC2.1 (R), J1.3, U6.4 (VIB)
ISO_SPI_NSS: IC3.1 (R), J1.2, R54.1, U5.2 (A), U6.5 (VIC)
ISO_SPI_SCK: IC1.1 (R), J1.4, U6.3 (VIA)
unnamed: IC4.6 (A), PAD9.1, R12.2
unnamed: IC4.7 (B), PAD10.1, R12.1
unnamed: IC3.6 (A), PAD7.1, R11.2
unnamed: IC3.7 (B), PAD8.1, R11.1
unnamed: IC2.6 (A), PAD5.1, R10.2
unnamed: IC2.7 (B), PAD6.1, R10.1
unnamed: IC1.7 (B), PAD4.1, R9.1
unnamed: IC1.6 (A), PAD3.1, R9.2
SPI_MISO: U6.11 (VID); also elsewhere on the board
SPI_MOSI: U6.13 (VOB); also elsewhere on the board
SPI_NSS: U6.12 (VOC); also elsewhere on the board
SPI_SCK: U6.14 (VOA); also elsewhere on the board
SS: IC4.3 (DE), U5.4 (Y), U6.7 (VE1)

Notes on the sheet:
Differential drivers, use if load is connected to main unit using long wires. Do not use terminating resistors if devices are connected to common bus, only the last one on the end of the bus should have them.
Digital isolator
Connector for connecting to main unit. If employed, do not use differential transceivers.

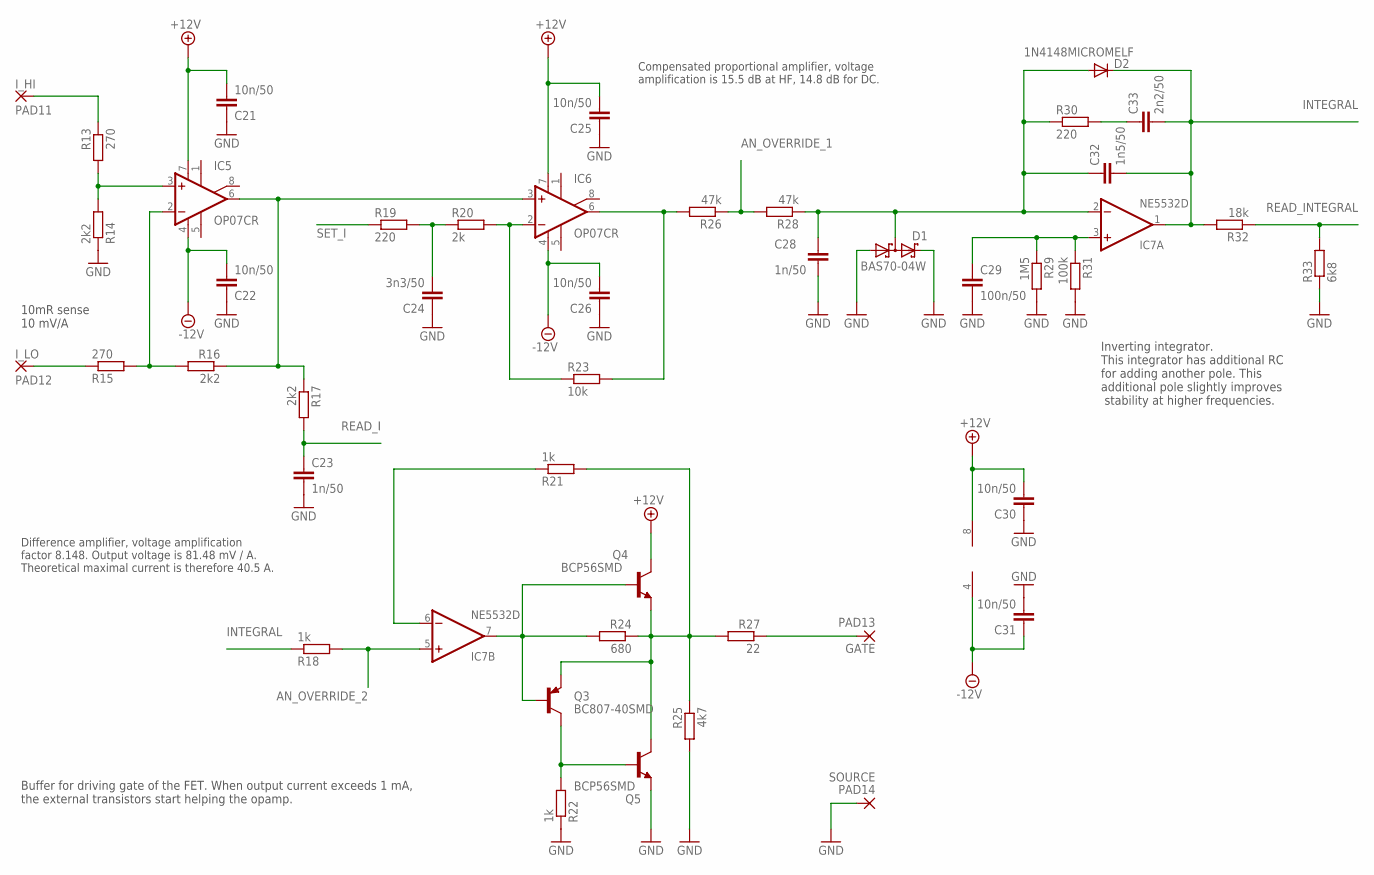
[picture p25: schematic proudomodul3.sch, sheet 3, Regulator]

Parts:
C21, C22, C25, C26, C30, C31: 10n/50; C0805
C23, C28: 1n/50; C0805
C24: 3n3/50; C0805
C29: 100n/50; C0805
C32: 1n5/50; C0805
C33: 2n2/50; C0805
D1: BAS70-04W; SOT323
D2: 1N4148MICROMELF; MICROMELF-W
IC5, IC6: OP07CR; SO08
IC7: NE5532D; SO08
PAD11: I_HI; 2,15/1,0
PAD12: I_LO; 2,15/1,0
PAD13: GATE; 2,15/1,0
PAD14: SOURCE; 2,15/1,0
Q3: BC807-40SMD; SOT23-BEC
Q4, Q5: BCP56SMD; SOT223
R13, R15: 270; R0805
R14, R16, R17: 2k2; R0805
R18, R21, R22: 1k; R0805
R19, R30: 220; R0805
R20: 2k; R0805
R23: 10k; R0805
R24: 680; R0805
R25: 4k7; R0805
R26, R28: 47k; R0805
R27: 22; R0805
R29: 1M5; R0805
R31: 100k; R0805
R32: 18k; R0805
R33: 6k8; R0805

Connections:
+12V: C21.2, C25.2, C30.2, IC5.7 (V+), IC6.7 (V+), IC7.8 (V+), Q4.2 (C), Q4.4 (C); also elsewhere on the board
-12V: C22.2, C26.2, C31.1, IC5.4 (V-), IC6.4 (V-), IC7.4 (V-); also elsewhere on the board
AN_OVERRIDE_1: R26.1, R28.2; also elsewhere on the board
AN_OVERRIDE_2: IC7.5 (+IN), R18.2; also elsewhere on the board
GND: C21.1, C22.1, C23.2, C24.1, C25.1, C26.1, C28.2, C29.2, C30.1, C31.2, D1.1 (A1), D1.2 (C2), PAD14.1, Q5.3 (E), R14.1, R22.1, R25.2, R29.2, R31.2, R33.1; also elsewhere on the board
INTEGRAL: C32.2, C33.2, D2.C, IC7.1 (OUT), R18.1, R32.2
unnamed: C33.1, R30.2
unnamed: PAD11.1, R13.1
unnamed: PAD13.1, R27.1
unnamed: Q3.E, Q4.3 (E), Q5.2 (C), Q5.4 (C), R21.2, R24.1, R25.1, R27.2
unnamed: IC7.7 (OUT), Q3.B, Q4.1 (B), R24.2
unnamed: IC5.3 (+IN), R13.2, R14.2
unnamed: PAD12.1, R15.1
unnamed: IC5.2 (-IN), R15.2, R16.2
unnamed: C28.1, C32.1, D1.3 (C1A2), D2.A, IC7.2 (-IN), R28.1, R30.1
unnamed: C29.1, IC7.3 (+IN), R29.1, R31.1
unnamed: IC6.6 (OUT), R23.2, R26.2
unnamed: Q3.C, Q5.1 (B), R22.2
unnamed: IC7.6 (-IN), R21.1
unnamed: IC6.2 (-IN), R20.2, R23.1
unnamed: IC5.6 (OUT), IC6.3 (+IN), R16.1, R17.1
unnamed: C24.2, R19.2, R20.1
READ_I: C23.1, R17.2; also elsewhere on the board
READ_INTEGRAL: R32.1, R33.2; also elsewhere on the board
SET_I: R19.1; also elsewhere on the board

Notes on the sheet:
10mR sense 10 mV/A
Compensated proportional amplifier, voltage amplification is 15.5 dB at HF, 14.8 dB for DC.
Inverting integrator. This integrator has additional RC for adding another pole. This additional pole slightly improves stability at higher frequencies.
Buffer for driving gate of the FET. When output current exceeds 1 mA, the external transistors start helping the opamp.
Difference amplifier, voltage amplification factor 8.148. Output voltage is 81.48 mV / A. Theoretical maximal current is therefore 40.5 A.

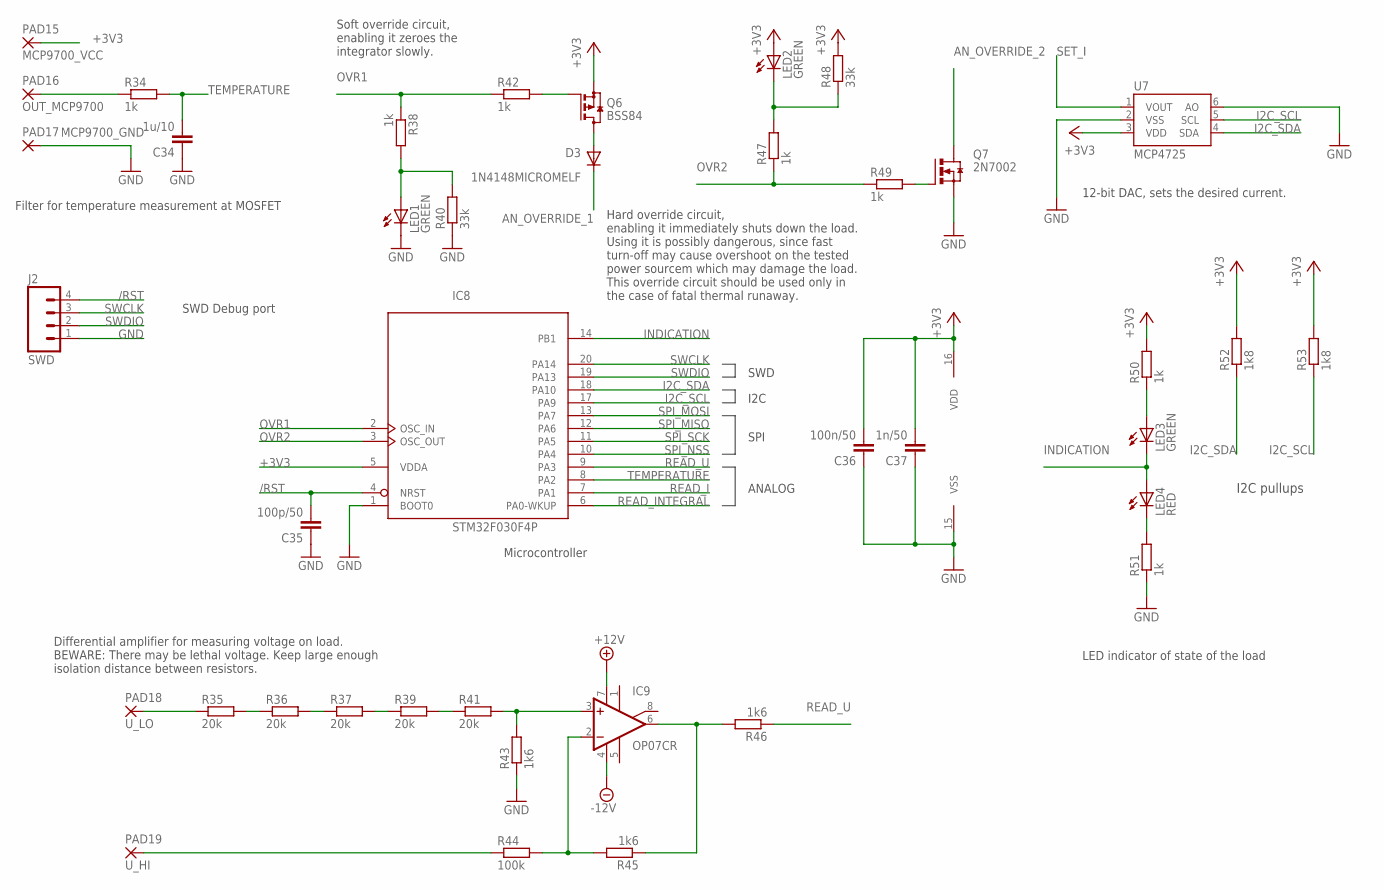
[picture p26: schematic proudomodul3.sch, sheet 4, Controller]

Parts:
C34: 1u/10; C0805
C35: 100p/50; C0805
C36: 100n/50; C0805
C37: 1n/50; C0805
D3: 1N4148MICROMELF; MICROMELF-W
IC8: STM32F030F4P; TSSOP20-I
IC9: OP07CR; SO08
J2: SWD; 1X04_SMD_STRAIGHT_COMBO
LED1, LED2, LED3: GREEN; SML0603
LED4: RED; SML0603
PAD15: MCP9700_VCC; 2,15/1,0
PAD16: OUT_MCP9700; 2,15/1,0
PAD17: MCP9700_GND; 2,15/1,0
PAD18: U_LO; 2,15/1,0
PAD19: U_HI; 2,15/1,0
Q6: BSS84; SOT23
Q7: 2N7002; SOT23-BEC
R34, R38, R42, R47, R49, R50, R51: 1k; R0805
R35, R36, R37, R39, R41: 20k; R0805
R40, R48: 33k; R0805
R43, R45, R46: 1k6; R0805
R44: 100k; R0805
R52, R53: 1k8; R0805
U7: MCP4725; SOT23-6

Connections:
+3V3: C36.2, C37.2, IC8.5 (VDDA), IC8.16 (VDD), LED2.A, PAD15.1, Q6.2 (S), R48.2, R50.2, R52.2, R53.2, U7.3 (VDD); also elsewhere on the board
+12V: IC9.7 (V+); also elsewhere on the board
-12V: IC9.4 (V-); also elsewhere on the board
/RST: C35.2, IC8.4 (NRST), J2.4
AN_OVERRIDE_1: D3.C; also elsewhere on the board
AN_OVERRIDE_2: Q7.C (D); also elsewhere on the board
GND: C34.1, C35.1, C36.1, C37.1, IC8.1 (BOOT0), IC8.15 (VSS), J2.1, LED1.C, PAD17.1, Q7.E (S), R40.1, R43.1, R51.1, U7.2 (VSS), U7.6 (AO); also elsewhere on the board
I2C_SCL: IC8.17 (PA9), R53.1, U7.5 (SCL)
I2C_SDA: IC8.18 (PA10), R52.1, U7.4 (SDA)
INDICATION: IC8.14 (PB1), LED3.C, LED4.A
unnamed: LED1.A, R38.2, R40.2
unnamed: Q6.1 (G), R42.2
unnamed: Q7.B (G), R49.2
unnamed: D3.A, Q6.3 (D)
unnamed: LED2.C, R47.2, R48.1
unnamed: PAD16.1, R34.1
unnamed: IC9.3 (+IN), R41.2, R43.2
unnamed: LED3.A, R50.1
unnamed: IC9.2 (-IN), R44.2, R45.2
unnamed: IC9.6 (OUT), R45.1, R46.2
unnamed: R39.2, R41.1
unnamed: R37.2, R39.1
unnamed: R36.2, R37.1
unnamed: R35.2, R36.1
unnamed: PAD19.1, R44.1
unnamed: PAD18.1, R35.1
unnamed: LED4.C, R51.2
OVR1: IC8.2 (OSC_IN), R38.1, R42.1
OVR2: IC8.3 (OSC_OUT), R47.1, R49.1
READ_I: IC8.7 (PA1); also elsewhere on the board
READ_INTEGRAL: IC8.6 (PA0-WKUP); also elsewhere on the board
READ_U: IC8.9 (PA3), R46.1
SET_I: U7.1 (VOUT); also elsewhere on the board
SPI_MISO: IC8.12 (PA6); also elsewhere on the board
SPI_MOSI: IC8.13 (PA7); also elsewhere on the board
SPI_NSS: IC8.10 (PA4); also elsewhere on the board
SPI_SCK: IC8.11 (PA5); also elsewhere on the board
SWCLK: IC8.20 (PA14), J2.3
SWDIO: IC8.19 (PA13), J2.2
TEMPERATURE: C34.2, IC8.8 (PA2), R34.2

Notes on the sheet:
I2C
SWD
SPI
ANALOG
Filter for temperature measurement at MOSFET
Soft override circuit, enabling it zeroes the integrator slowly.
Hard override circuit, enabling it immediately shuts down the load. Using it is possibly dangerous, since fast turn-off may cause overshoot on the tested power sourcem which may damage the load. This override circuit should be used only in the case of fatal thermal runaway.
12-bit DAC, sets the desired current.
SWD Debug port
I2C pullups
Differential amplifier for measuring voltage on load. BEWARE: There may be lethal voltage. Keep large enough isolation distance between resistors.
Microcontroller
LED indicator of state of the load

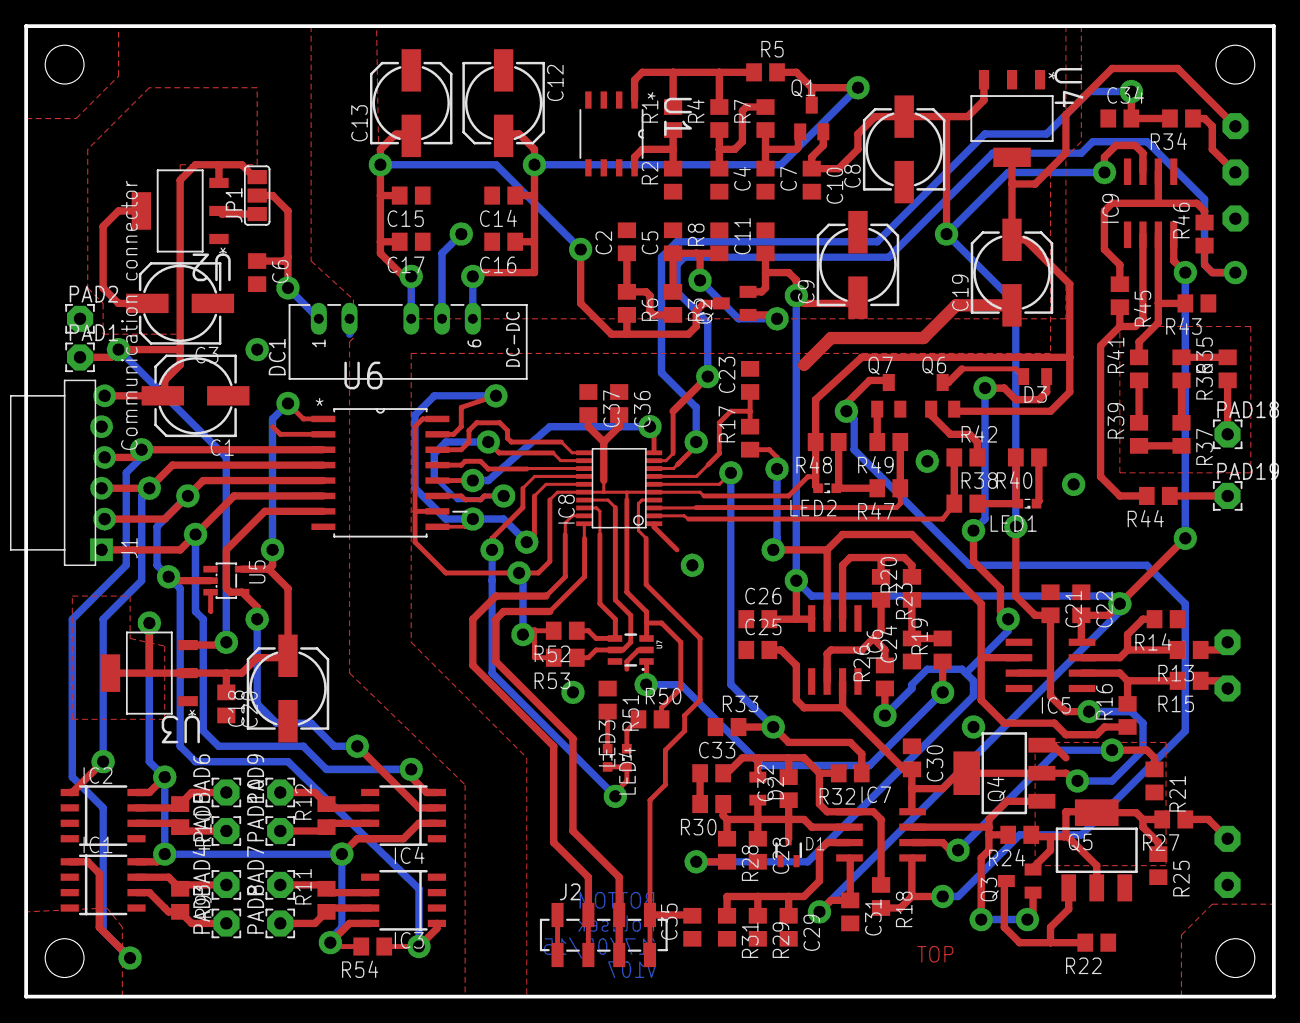
[picture p27: board proudomodul3.brd from above]

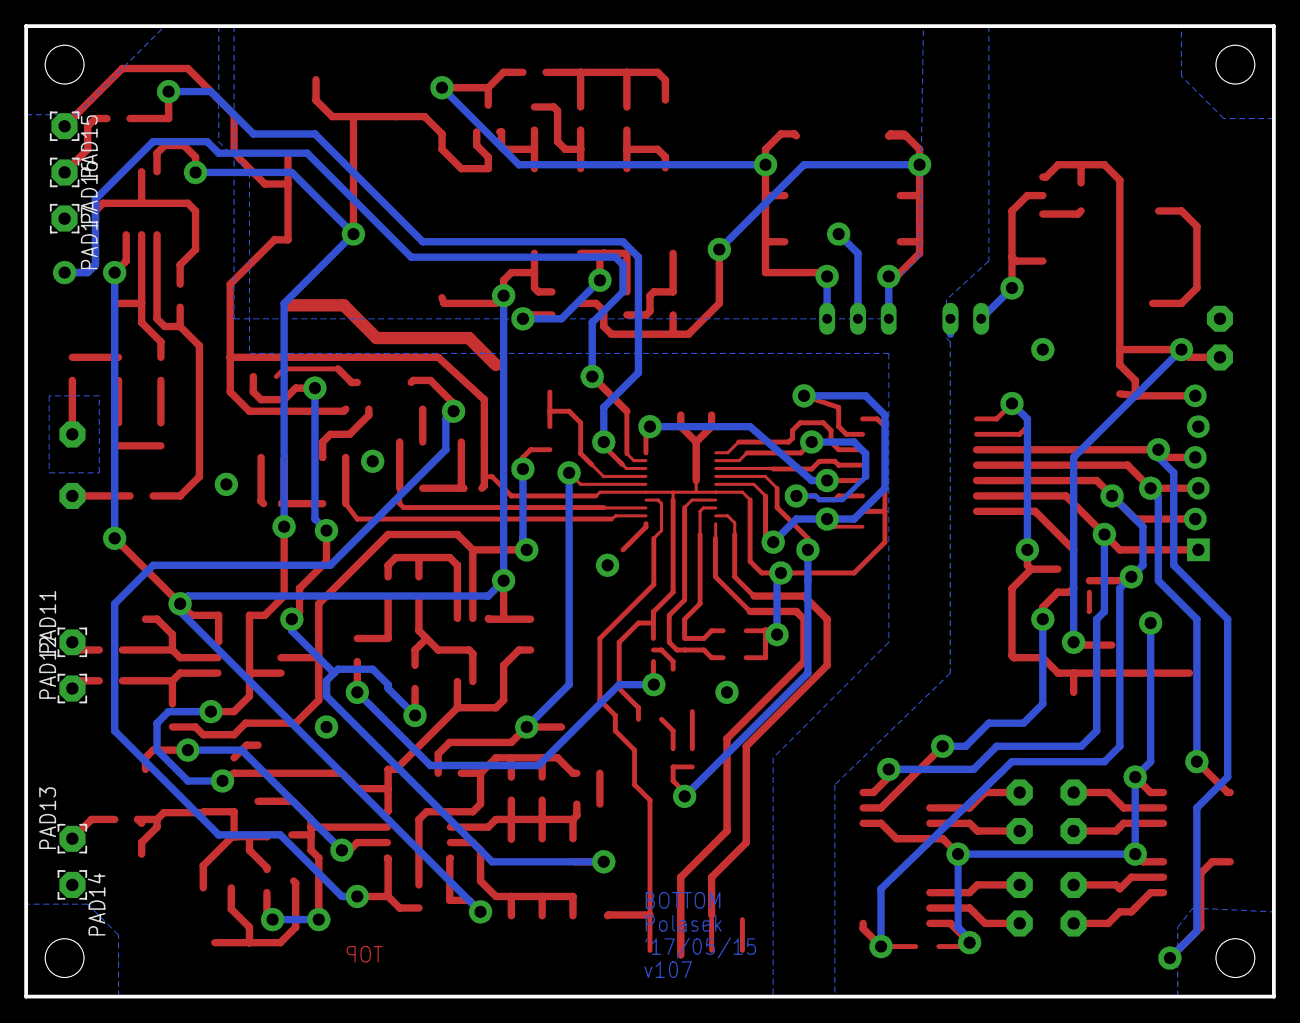
[picture p28: board proudomodul3.brd from below]

Board: 2 copper layers, 102.9 x 80.0 mm, 143 parts (7 on the bottom side), 84 nets.
